anananu/Square-wave-Generator/Simulations/Temperatura2.jpg

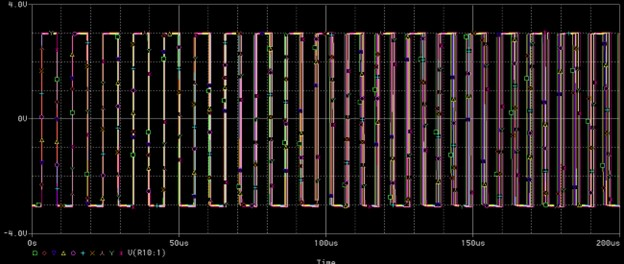
Simulations/Temperatura2.jpg
