anananu/Square-wave-Generator/Simulations/Temperatura1.jpg

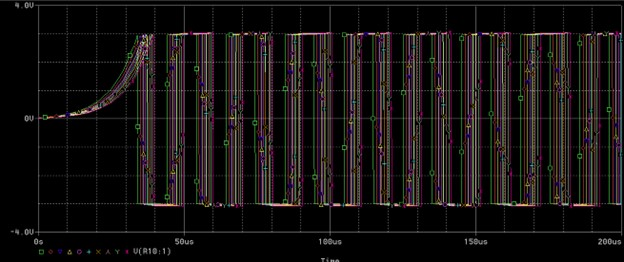
Simulations/Temperatura1.jpg
