anananu/Square-wave-Generator/P1_2023_434D_Nanu_AnaMaria_final.pptx

## Proiect 1 – Dispozitive și circuite electronice (DCE)

Tema: Generator de semnal dreptunghiular

Student: Nanu Ana-Maria
Grupa: 434D

## Date de proiectare

Cerințe electrice:
• Frecvența de oscilație, f_0 , reglabilă în intervalul 48-96 KHz;
• Factor de umplere: 0.5;
• Sarcina la ieșire, R_L : 24kΩ;
• Valoarea (vârf la vârf) a oscilației la ieșire, V_0 , reglabilă în intervalul 0-6V;
• Semnalul la ieșire nu are componentă continuă;
• Domeniul temperaturilor de funcționare: -20° - 120°C
• Semnalizarea prezenței tensiunilor de intrare/ieșire cu o diodă de tip LED
Cerințe tehnologice:
- Dimensiunile PCB: 40mm x 40mm;
- Material FR4, dublu strat;
- Originea (punctul de coordonate (0,0)) va fi plasat în colţul din stânga-jos al plăcii de cablaj imprimat)
- Dimensiuni trasee:
      - Curent de 1A - 30 mil;
      - Curent de sute de mA - 20 mil;
      - Semnal - 16 mil;

## Schema bloc

Oscilatorul de relaxare este constituit dintr-un comparator inversor cu histerezis și o rețea RC pe intrarea inversoare.
Intrarea neinversoare este conectată la un divizorul de tensiune, prin intermediul căruia de aplică o parte din semnalul de la ieșire și prin care se fixează tensiunile de prag de histerezis.
Gruparea RC, la care se adaugă un potențiometru, setează frecvența de oscilație.
Amplificatorul operațional este alcătuit din trei etaje de amplificare.

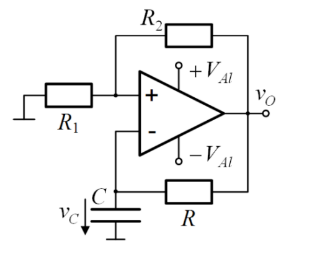
[picture p3: figure]
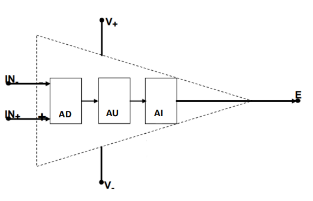
[picture p4: figure]

## Schema electrică

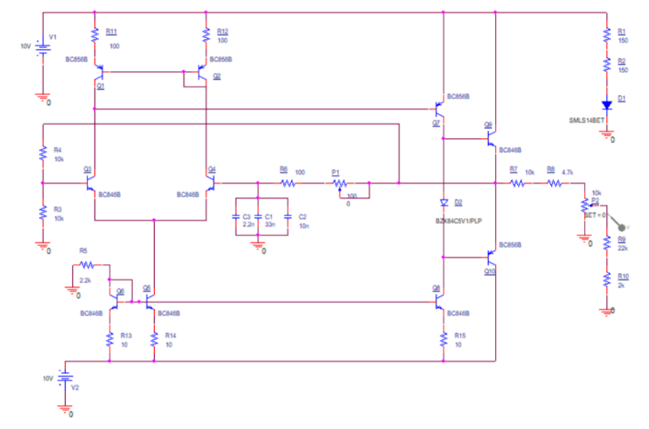
[picture p5: figure]

Etaj diferențial

Etaj de
amplificare
în curent

LED

Divizor rezistiv

Gruparea RC

Rezistența
de
sarcină

Etaj de amplificare în tensiune

## Simulări

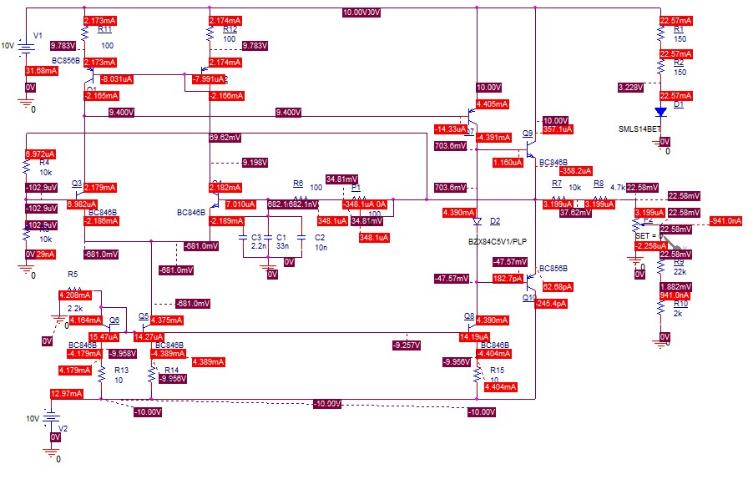
[picture p6: figure]

## Simulări

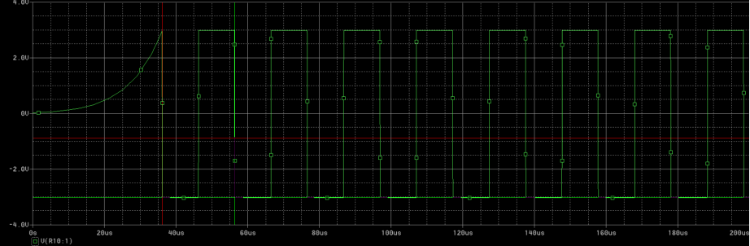
[picture p7: figure]
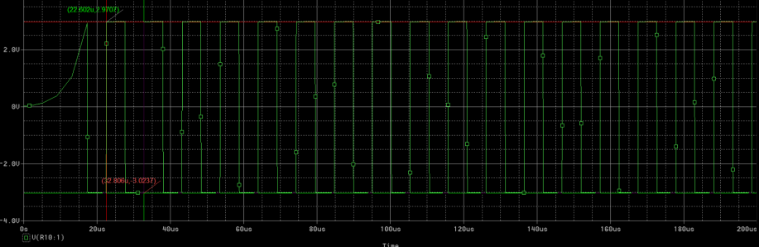
[picture p8: figure]

## Layout

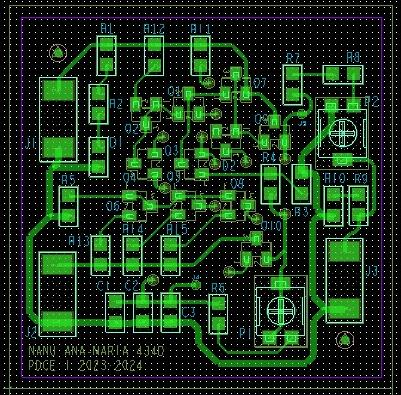
[picture p9: figure]

Vedere Top
Poziționarea componentelor s-a realizat pe baza următoarelor condiții:
- Componentele pasive au fost așezate spre exteriorul plăcii, iar cele active, în mijloc.
- Tranzistoarele au fost plasate cât mai aproapiate pentru a concentra distribuția căldurii.

## Layout

Vedere Bottom
- Dimensiunile traseelor s-au setat în concordață cu cerințele de proiectare.

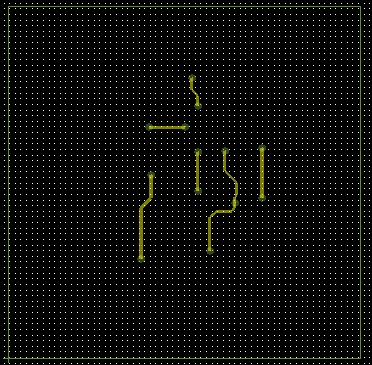
[picture p10: figure]

## Fotografii din etapa de echipare a modulului electronic

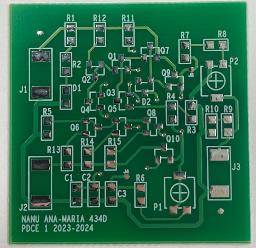
[picture p11: figure]
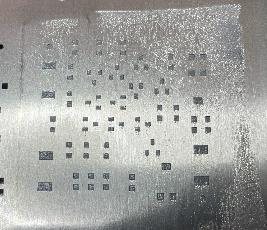
[picture p12: figure]
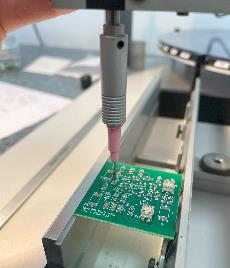
[picture p13: figure]
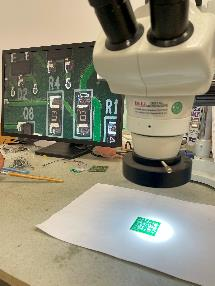
[picture p14: figure]
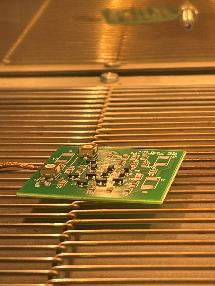
[picture p15: figure]
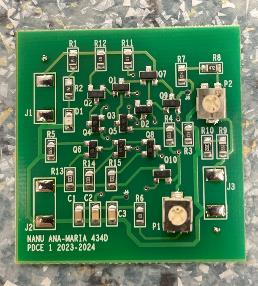
[picture p16: figure]

## Rezultate experimentale

Realizarea montajului pentru testarea modulului

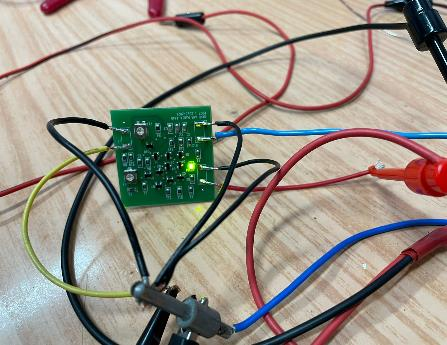
[picture p17: figure]

1

1

4

3

1

2

1. Firele negre – Ground
2. Firul roșu – Alimentarea cu +Vcc

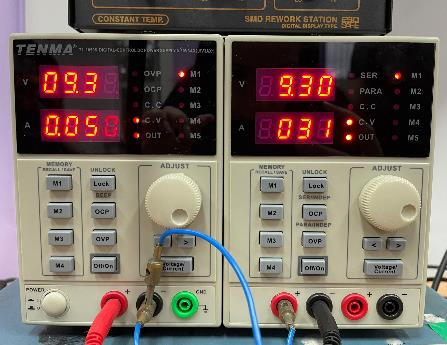
[picture p18: figure]

3. Firul albastru – Alimentarea cu –Vcc
4. Firul galben - Vout

## Rezultate experimentale

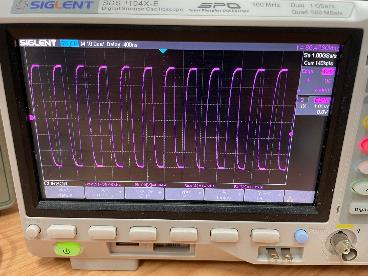
[picture p19: figure]

f = 86.473 kHz, V_0 = 6.04 V_(PP)

Formele de undă obținute

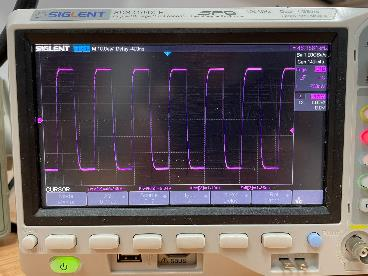
[picture p20: figure]
f = 48kHz, A = 6Vpp

f = 48.256 kHz, V_0 = 6.04 V_(PP)

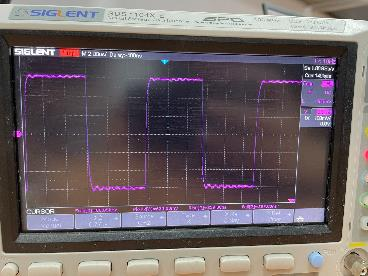
[picture p21: figure]

f = 86.85 kHz, V_0 = 0.62 V_(PP)

## Rezultate experimentale

- Tabel comparativ

Cerințe impuse | Rezultate simulări | Rezultate măsurători
f_(min) =48kHz | f_(min) =49.27kHz | f_(min) =48.256kHz
f_(max) =96kHz | f_(max) =96kHz | f_(max) =86.85kHz
V_(0_(min)) =0V_(PP) | V_(0_(min)) =743nV_(PP) | V_(0_(min)) =0.62V_(PP)
V_(0_(max)) =6V_(PP) | V_(0_(max)) =5.99V_(PP) | V_(0_(max)) =6.04V_(PP)
η=0.5 | η=0.51 | η=0.49
V_(offset) =0V_(PP) | V_(offset) =0.023V_(PP) | V_(offset) =0V_(PP)

## Concluzii – rezultatele obținute

Avantaje
- Frecvența minimă rezultată din măsurători a fost mai aproape de cea din cerințele de proiectare, decât cea simulată.
- Factorul de umplere și offset-ul au avut deviații neglijabile în comparație cu valorile dorite.
- Valorile amplitudinii au rămas apropiate de cele din cerință. În ceea ce privește tensiunea minimă, aceasta a ajuns la valori foarte apropiate de 0, însă am fotografiat o valoare minimă pentru care se vedea forma de undă dorită.

Dezavantaje
- Frecvența maximă nu a ajuns la pragul dorit de 96kHz, fapt datorat potențiometrului P_2 , cu valoarea nominală de 10kΩ, care, în urmă măsurătorilor, a avut valoarea maximă de 8.56kΩ, fapt ce a condus la o eroare considerabilă, de 9.56%. O îmbunătățire ce ar putea fi adusă în acest caz, ar fi schimbarea potențiometrului și luarea în considerare a toleranței acestuia.
- Semnalul obținut nu a avut întocmai forma de undă perfect dreptunghiulară, fapt ce se datorează grupării de condensatoare C_1 , C_2 , C_3 . Corectarea ar fi putut fi făcută prin alegerea mai potrivită a valorilor acestora.

## Concluzii

- Plan de depanare –
organigrama
- Cunoștințe dobândite: Calculul și proiectarea circuitelor după anumite cerințe impuse, teoria circuitelor electronice fundamentale, depanarea circuitelor, utilizarea software-ului de proiectare OrCAD
- Consider că acest proiect a reprezentat o bună punere în practică a cunoștințelor dobândite la materiile anterioare și că am fixat mult mai bine o parte dintre noțiuni
- Modalitatea de desfășurare cred că a fost una bine structurată, însă o îmbunătățire semnificativă ar fi planificarea din timp a evaluărilor astfel încât să nu se întindă pe mai mult de 2 săptămâni și a deadline-urilor pentru încărcarea proiectelor pentru ca toată lumea să poată posta la timp

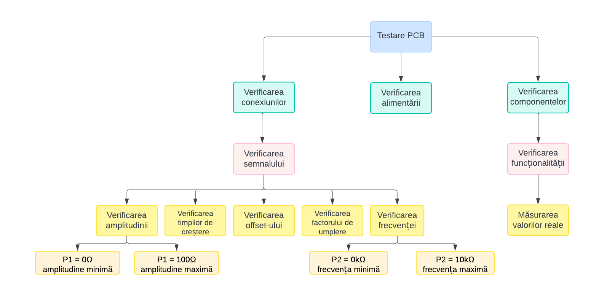
[picture p22: figure]

## Discipline studiate utile în realizarea proiectului

- Disciplinele din care au fost utilizate cunoștințe/informații pentru realizarea proiectului
  1. Dispozitive Electronice
  2. Circuite Integrate Analogice
  3. Circuite Electronice Fundamentale
  4. Tehnici CAD în realizarea modulelor electronice
  5. Tehnologii de interconectare în electronică
  6. Componente și circuite pasive
  7. Bazele Electrotehnicii
- Ce discipline, aflate în semestrele din amonte, ar fi trebuit să fie mai bine însușite pentru ușurarea realizării activităților conexe proiectului?
  1. Dispozitive Electronice
  2. Circuite Electronice Fundamentale
  3. Circuite Integrate Analogice
