anananu/Square-wave-Generator/Documentație.pdf

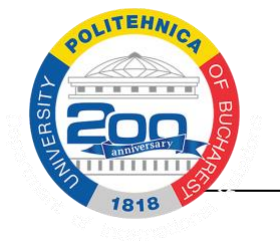
[picture p23: figure]
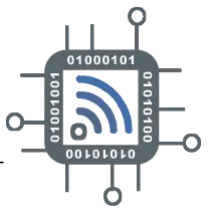
[picture p24: figure]

## UNIVERSITATEA NAȚIONALĂ DE ȘTIINȚĂ ȘI TEHNOLOGIE POLITEHNICA BUCUREȘTI

### Facultatea de Electronică, Telecomunicații și Tehnologia Informației

## Proiect 1 – Dispozitive și circuite electronice

## Generator de semnal dreptunghiular

### Student: Nanu Ana-Maria Grupa: 434D

### Profesori coordonatori: Conf. Dr. Ing. Drăghici Florin Ș.l. Dr. Ing. Pantazică Mihaela

# Cuprins

# 1.Date inițiale de proiectare

## 1.1. Tema proiectului

### Să se proiecteze și realizeze un generator de semnal dreptunghiular cu următoarele caracteristici:

- Frecvența de oscilație, f0, reglabilă în intervalul 48-96 KHz;
- Factor de umplere: 0.5;

### - Sarcina la ieșire, RL

: 24kΩ;
- Valoarea (vârf la vârf) a oscilației la ieșire, Vo, reglabilă în intervalul 0-6V;
- Semnalul la ieșire nu are componentă continuă;

### - Domeniul temperaturilor de funcționare: -20° - 120°C (verificabil prin

testare în temperatură);
- Semnalizarea prezenței tensiunilor de intrare/ieșire cu o diodă de tip LED.

## 1.2. Schema bloc a montajului electric

Vom folosi un circuit basculant astabil, mai exact un oscilator de relaxare.

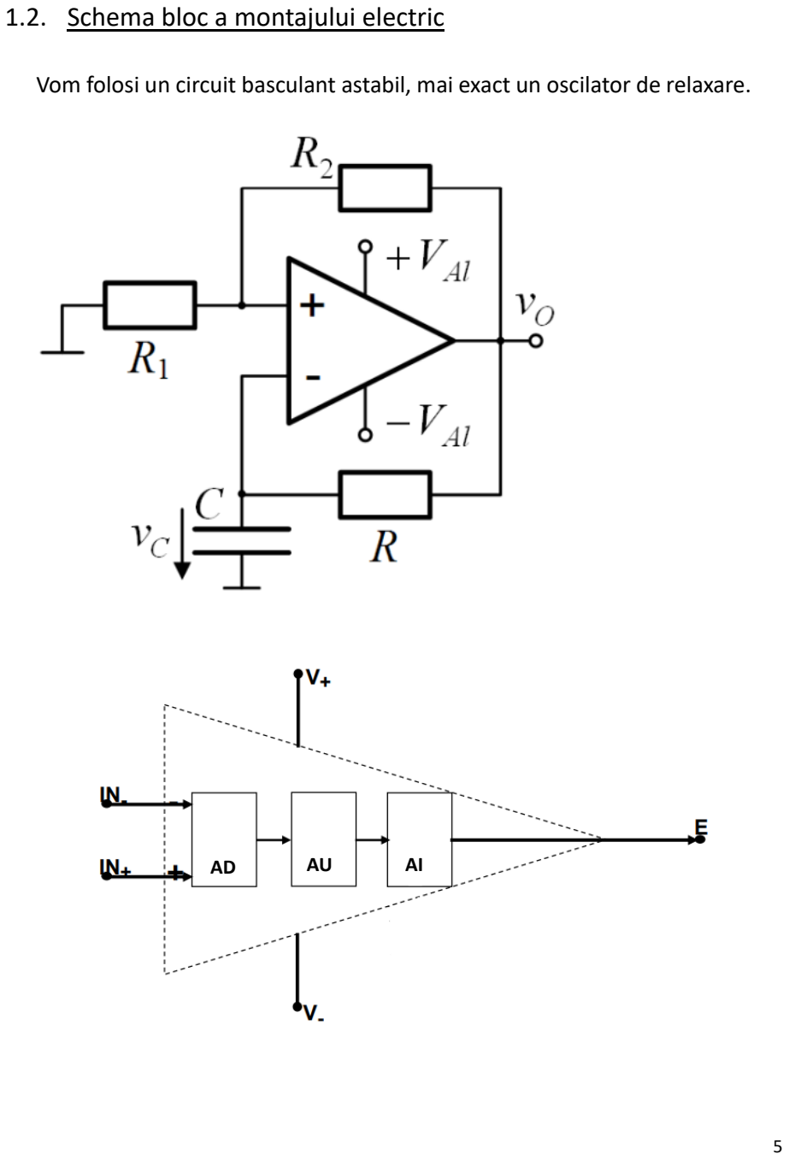
[picture p25: page 5]

AD | AU | AI

## 1.3. Schema electrică a montajului electric

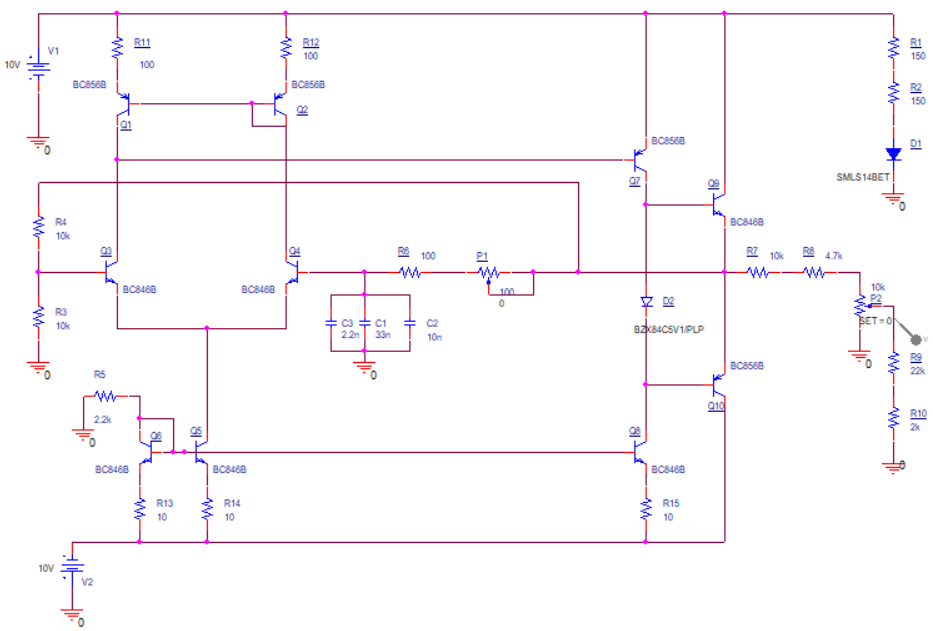
[picture p26: figure]

# 2.Conținut tehnic/științific al proiectului

## 2.1. Descrierea funcțională a circuitului

### Am construit un oscilator de relaxare dintr-un comparator inversor cu histerezis și

o rețea RC pe intrarea inversoare.

### Intrarea neinversoare este conectată la divizorul de tensiune format din R3 și R4, prin intermediul căruia de aplică o parte din semnalul de la ieșire și prin care se fixează

tensiunile de prag de histerezis.

Gruparea formată din C1, C2, R7 și P1 setează frecvența de oscilație.

### Amplificatorul operațional folosit este unul standard, format din 3 etaje de amplificare:

- etaj de amplificare diferențială;
- etaj de amplificare în tensiune;
- etaj de amplificare în curent.

Am folosit două surse de alimentare de ±10V.

### 2.1.1. Etajul diferențial

### Acest etaj este unul de tip transconductanță, transformând un semnal de tip tensiune, într-unul de tip curent. Acesta are o impedanță de intrare mare, ce permite adaptarea impedanței între sursa de semnal și următorul etaj din

amplificatorul operațional.

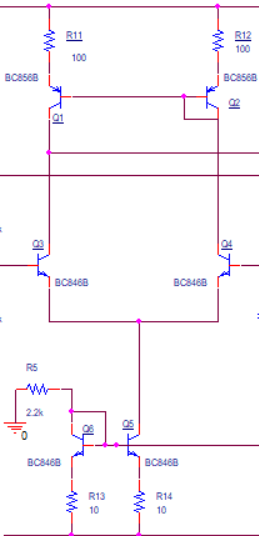
[picture p27: figure]

### Etajul principal este format din tranzistoarele Q3 și Q4, NPN, de tip BC846B, în baza cărora se vor

afla intrările amplificatorului operațional.

### Pentru a mări câștigul, stabilitatea și pentru a reduce zgomotul, adăugăm două etaje auxiliare:

oglinda și sursa de curent.

### Tranzistoarele PNP, BC856B, Q1 și Q2 sunt folosite pentru a avea același curent în colectorul celor două tranzistoare ce formează principala parte

din etajul diferențial.

### Pentru polarizarea tranzistoarelor am folosit sursa de curent formată din Q5, Q6 și R5. Astfel am asigurat un IREF = 4.27mA ce permite crearea

unui semnal dreptunghiular perfect drept.

### 2.1.2. Etajul de amplificare în tensiune

### Am folosit un etaj de tip transimpedanță, ce are rolul de a obține

o tensiune mare, transformând curentul de la intrare.

### Având o amplificare mare în buclă deschisă, am folosit o buclă de reacție negativă pentru a adapta valoarea tensiunii la cea

specificată în datele inițiale de proiectare.

### Amplificarea este realizată de tranzistorul PNP, BC856B, Q7, aflat în conexiune emitor-comun, ceea ce face ca acesta să aibă o amplificare mare. Rolul său este de a regla tensiunea la valoarea

dorită. Are ca sarcină o sursă de curent formată din Q8.

Sursa de curent comandă curentul din etajul final.

### 2.1.3. Etajul de amplificare în curent

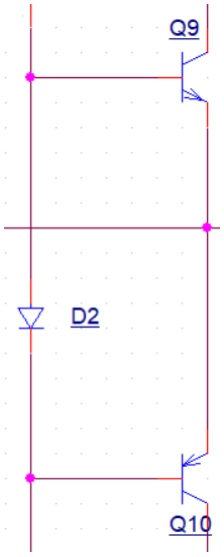
[picture p28: figure]

### Acest etaj ar trebui să aibă o amplificarea unitară a tensiunii reglate în etajul anterior, motiv pentru care s-a folosit o conexiune de tip colector comun. Tranzistorul Q9 este de tip BC846B, iar Q10 de tip BC856B. Ele vor disipa o putere semnificativă, datorită curentului care va trece și prin

sarcină.

### Cele două tranzistoare formează o configurație de tip push-

pull, specifică amplificatoarelor de clasă B. Q9 | este
responsabil pentru alternanța pozitivă, iar Q10 | pentru
alternanța negativă.

### Dioda Zener D1 stabilește tensiunile bază-emitor de deschidere pentru cele două tranzistoare și reduce

distorsiunile.

### 2.1.4. LED

Conform cerințelor am semnalizat tensiunile de intrare în circuit printr-un led de tip SMLS14BET, în serie cu rezistența R1 și R2. Luând în considerare puterea maximă admisă (117mW) și valoarea tensiunii de funcționare uzuală pentru acesta (3.32V), precum și curentul necesar pentru aprindere [0.1 – 1 A], am ales valoarea de 150Ω pentru

rezistențe.

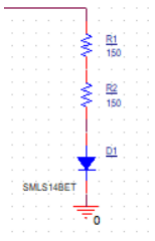
[picture p29: figure]

## 2.2. Calcul de dimensionare

### 2.2.1. Frecvența de oscilație

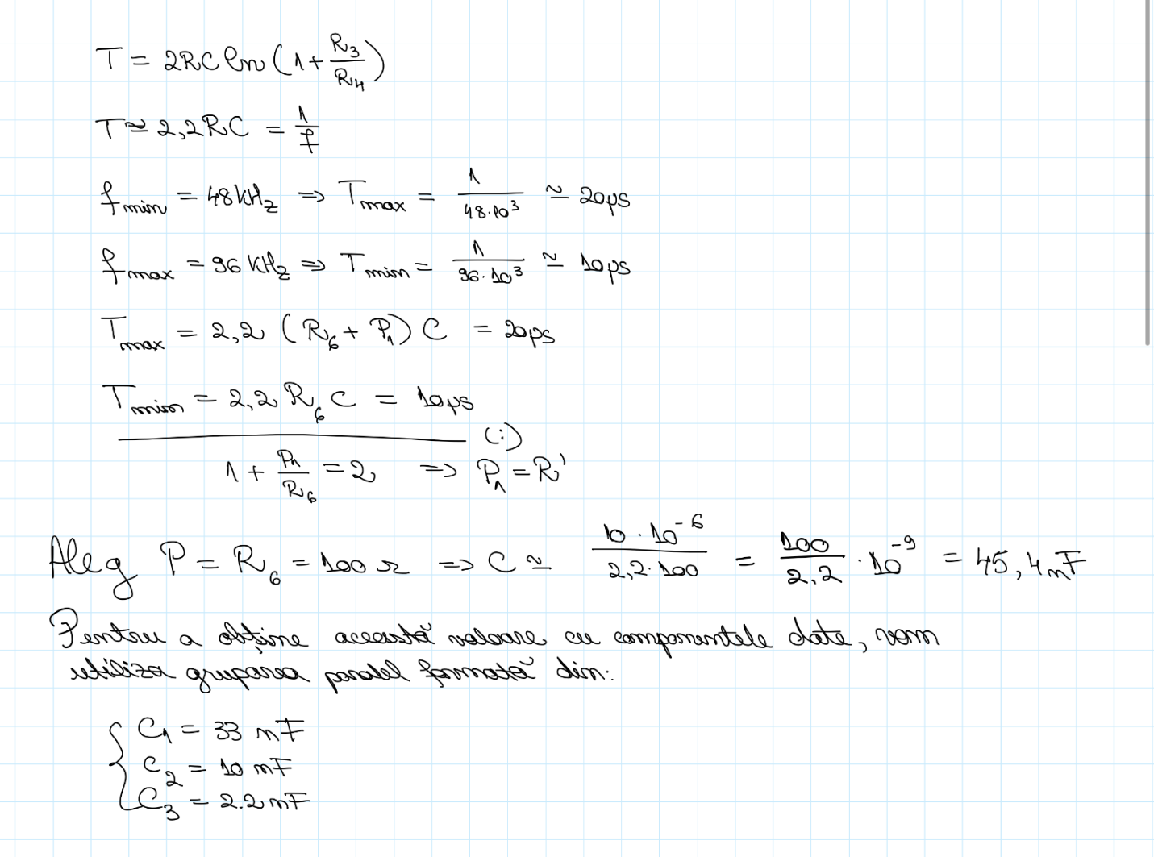
[picture p30: figure]

### 2.2.2. Tensiunea vârf la vârf

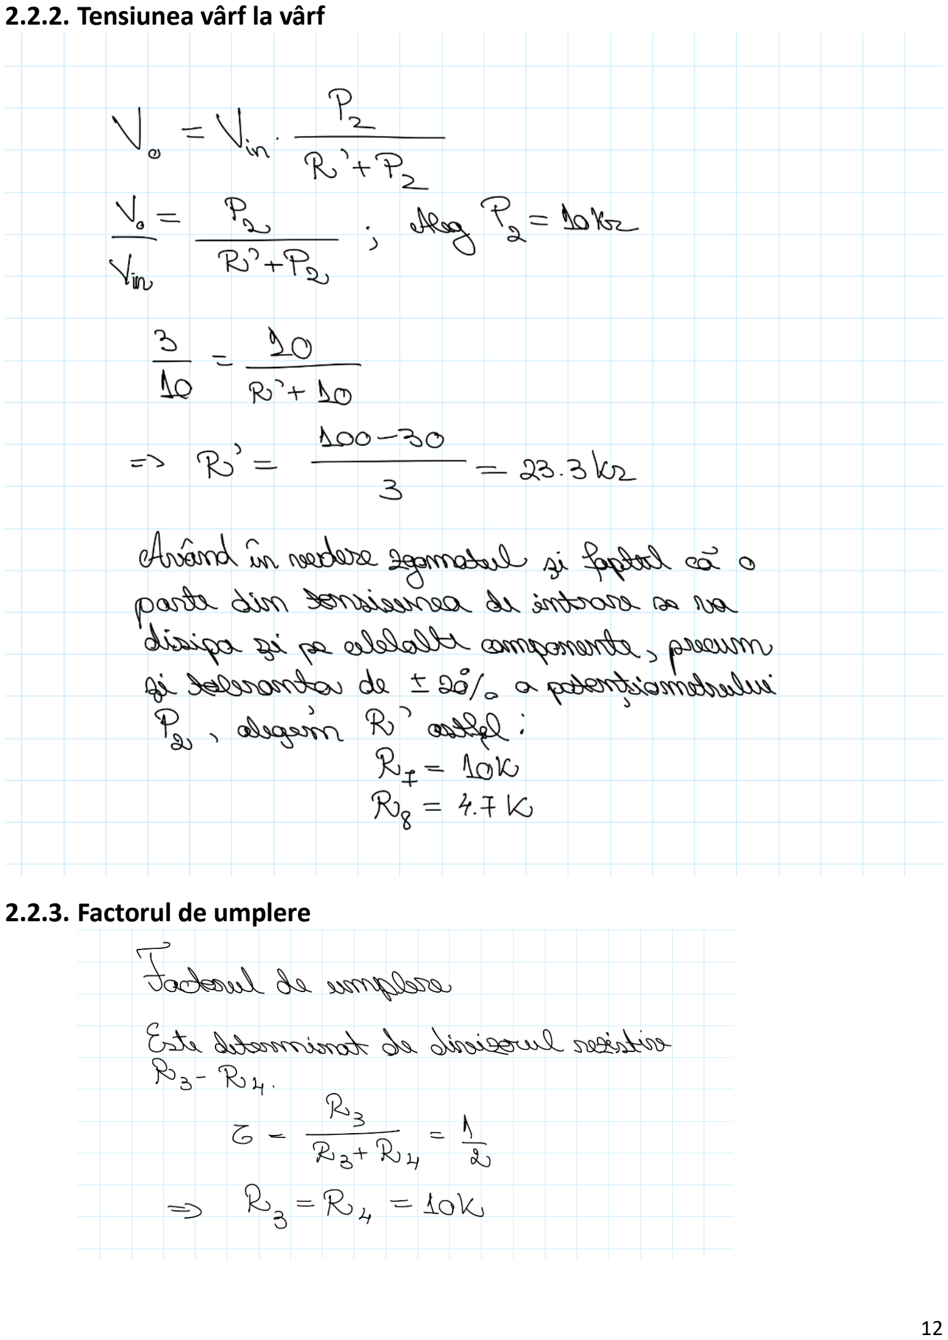
[picture p31: page 12]

### 2.2.3. Factorul de umplere

## 2.3. Punctul static de funcționare

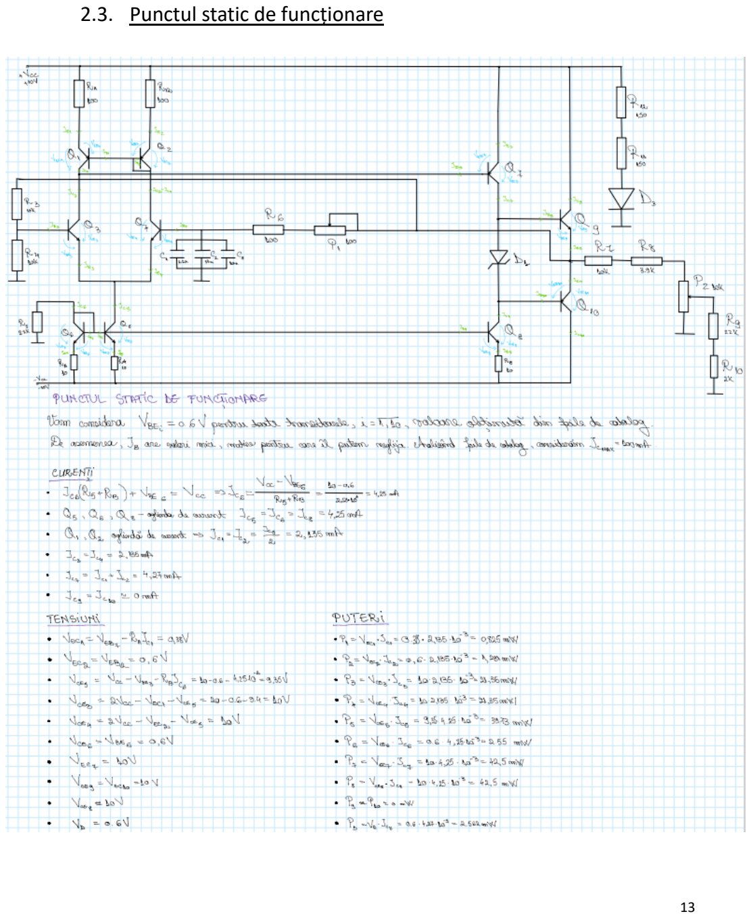
[picture p32: page 13]

# 3. Simularea montajului electric

## 3.1. Curenți

### Verificând foile de catalog ale componentelor, acestea merg în regulă la curenții

obținuți.

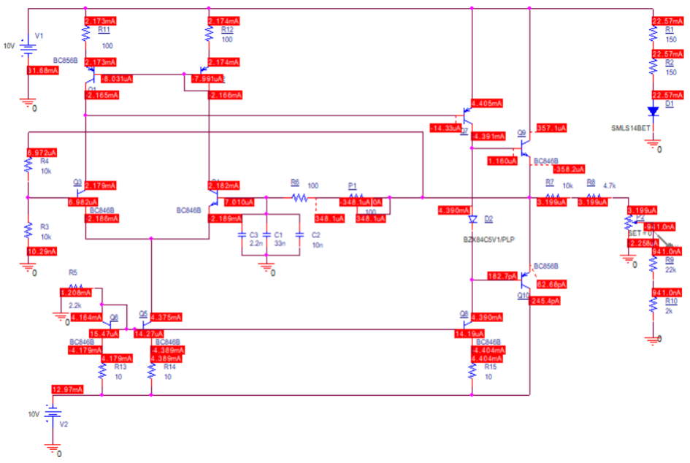
[picture p33: figure]

## 3.2. Tensiuni

### Verificând foile de catalog ale componentelor, acestea merg în regulă pentru

tensiunile obținute.

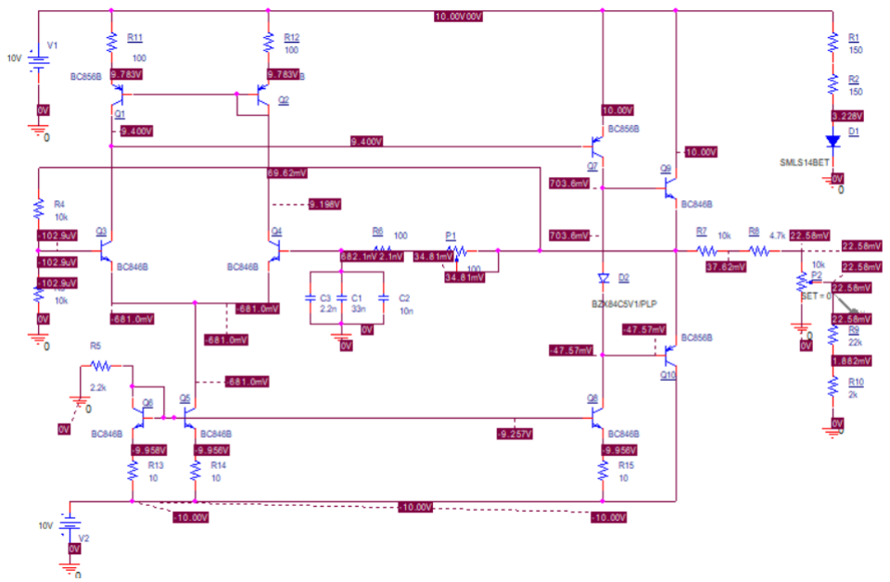
[picture p34: figure]

## 3.3. Puteri

### De asemenea, și puterile se încadrează în parametrii normali de funcționare a

componentelor.

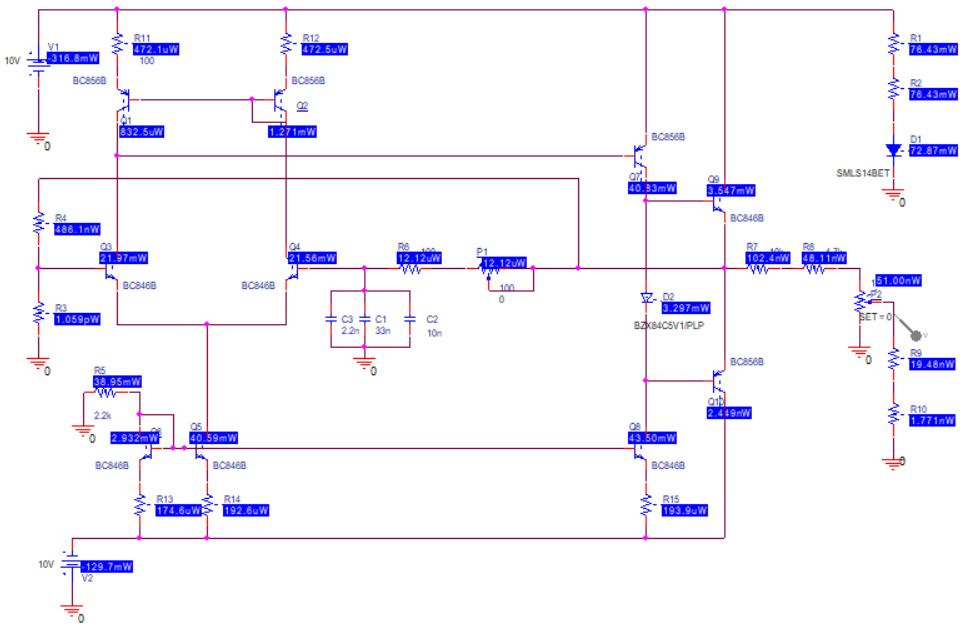
[picture p35: figure]

3.4. P1 = 0, P2 = 10kΩ.

### Pentru aceste valori se obțin:

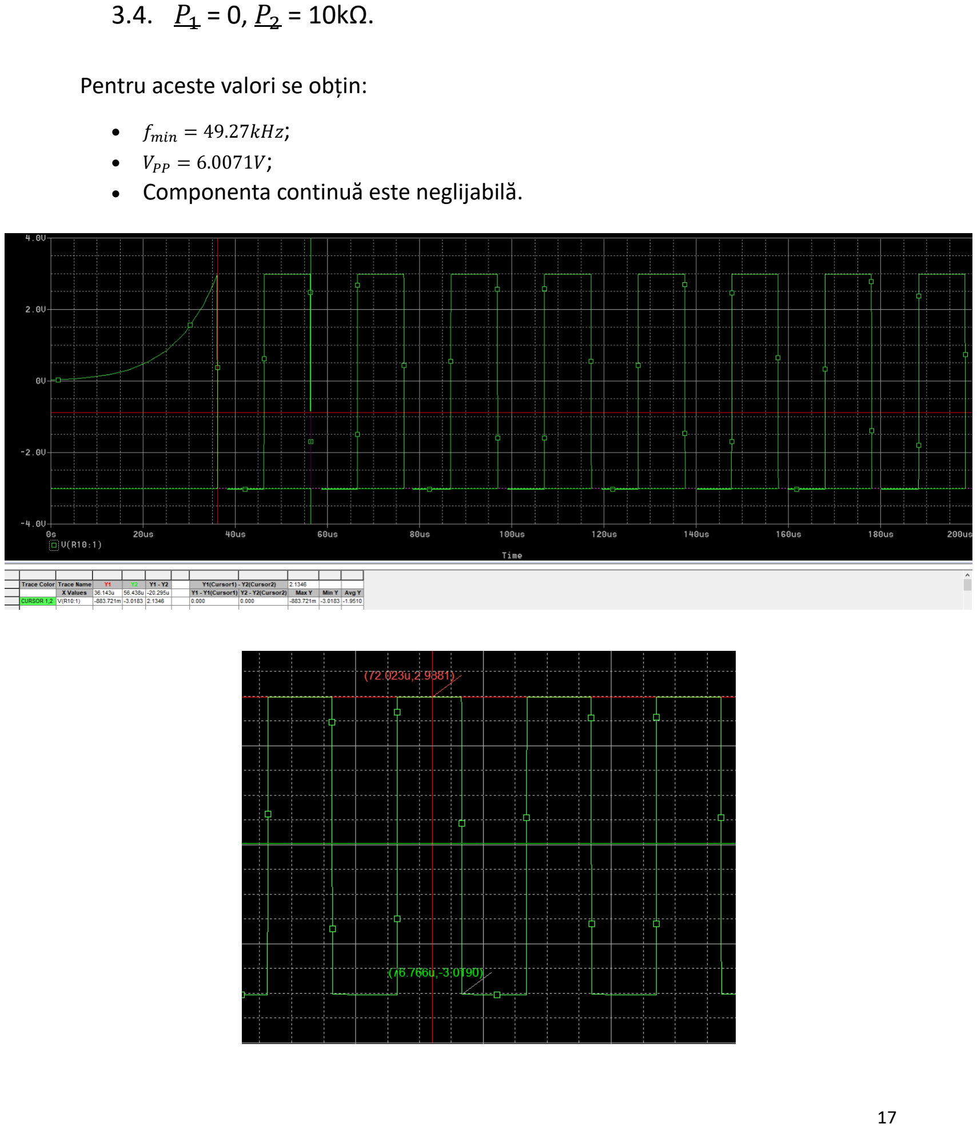
[picture p36: page 17]

- fmin = 49.27kHz;
- VPP = 6.0071V;
- Componenta continuă este neglijabilă.

3.5. P1 = 100Ω, P2 = 10kΩ.

### Pentru aceste valori se obțin:

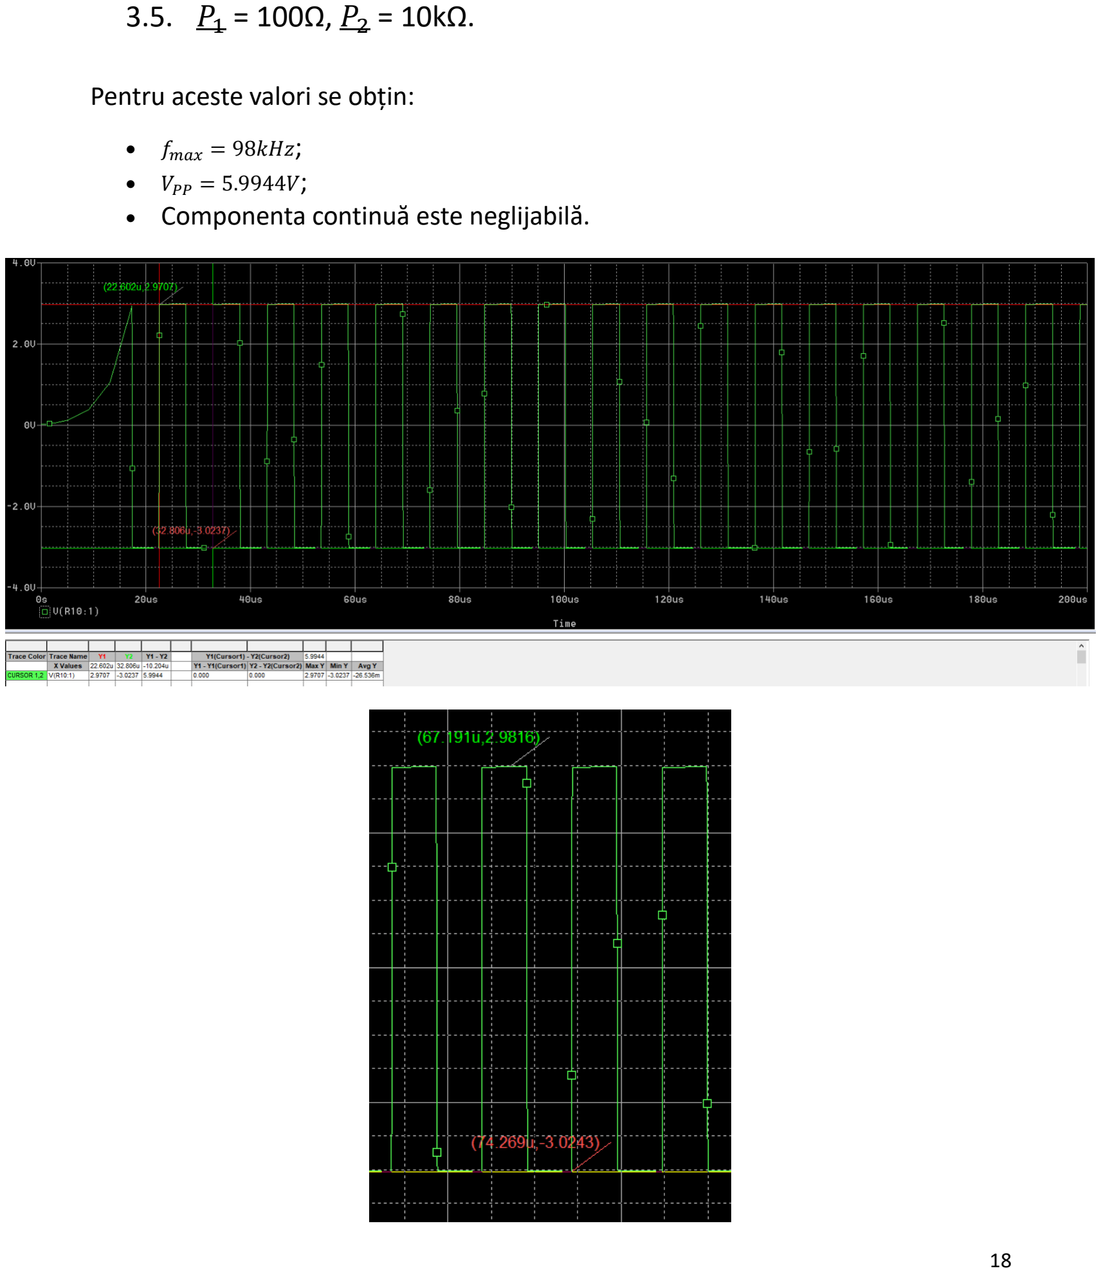
[picture p37: page 18]

- fmax = 98kHz;
- VPP = 5.9944V;
- Componenta continuă este neglijabilă.

## 3.6. P1 = 100Ω & P1 = 0, P2 = 0

### Pentru aceste valori se obțin:

- fmax = 98kHz & fmin = 49.27kHz;
- VPP = 743nV;

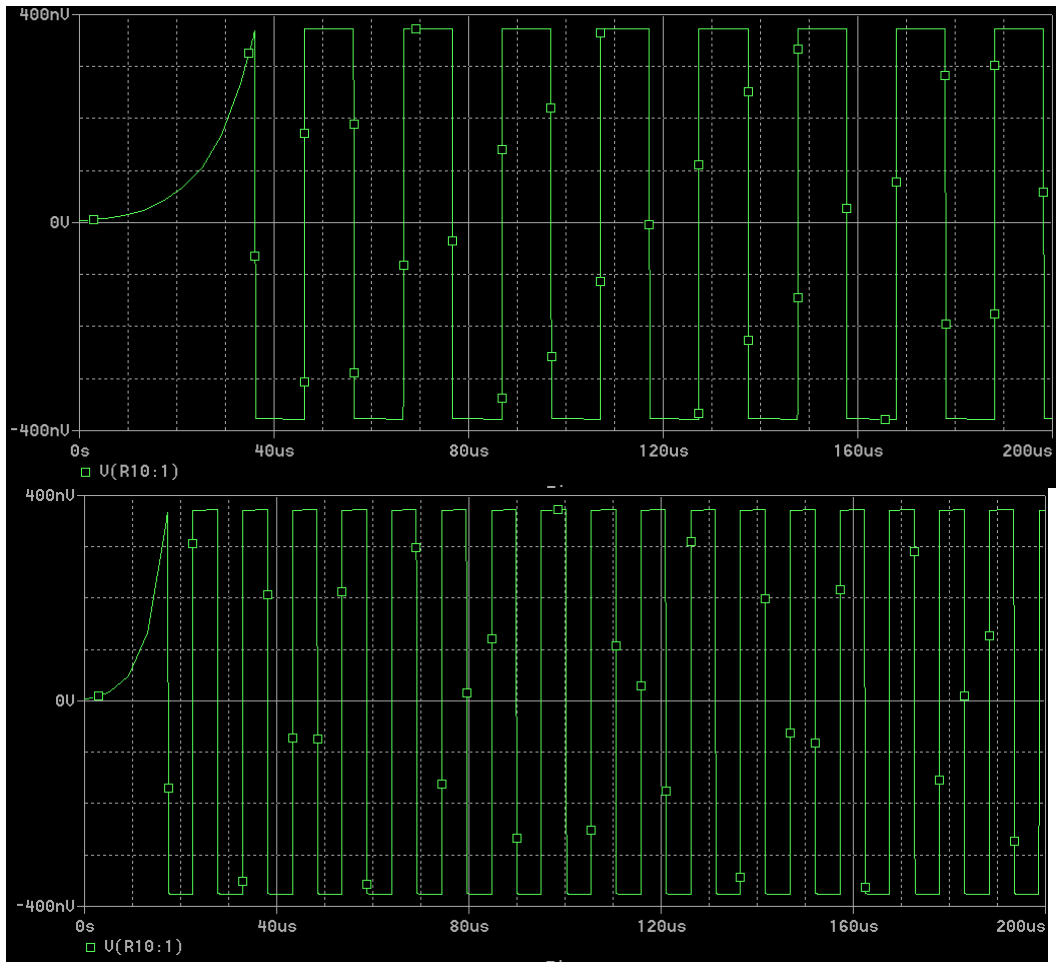
[picture p38: figure]

## 3.7. Temperatură

Am simulat funcționarea circuitului la -20°, 0°, 20°, 27°, 40°, 60°, 80°, 100°, 120°C, toate componentele funcționând normal în tot intervalul de temperatură.

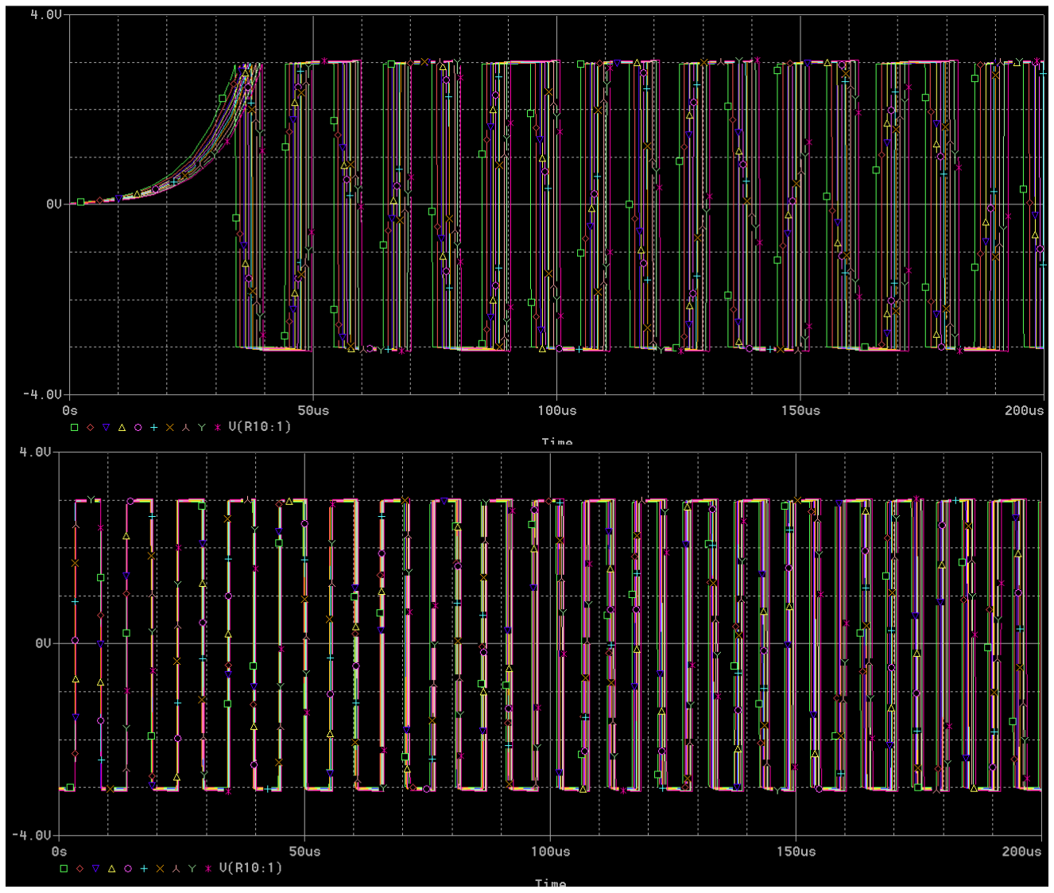
[picture p39: figure]

# 4.BOM

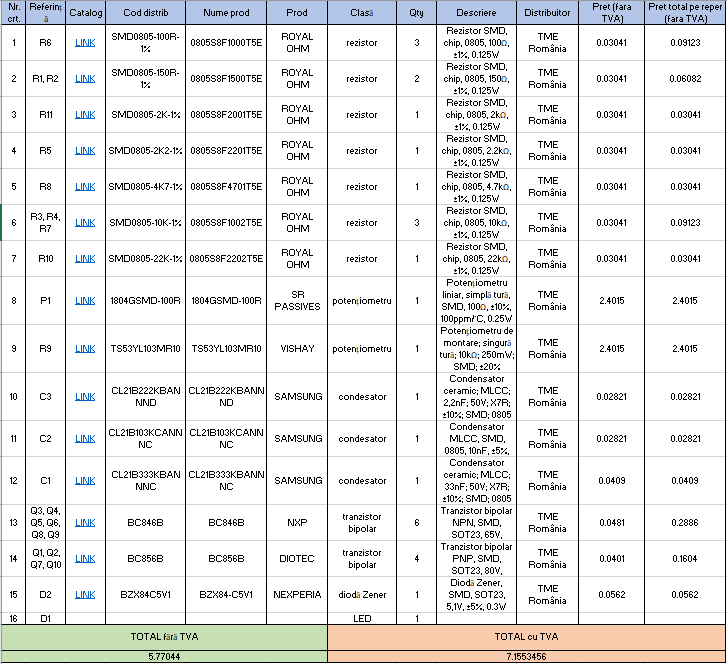
[picture p40: figure]

# 5. Layout

## 5.1. PCB design

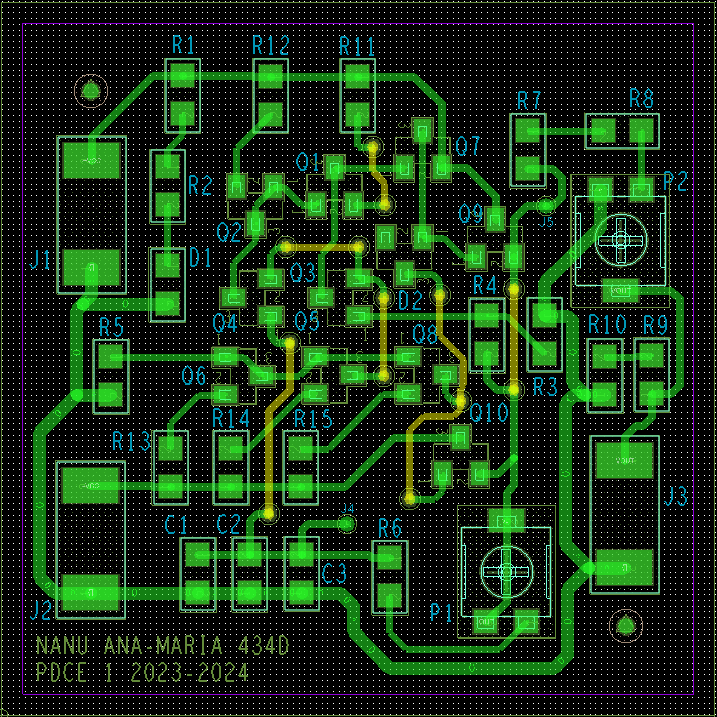
[picture p41: figure]

## 5.2. BOARD OUTLINE

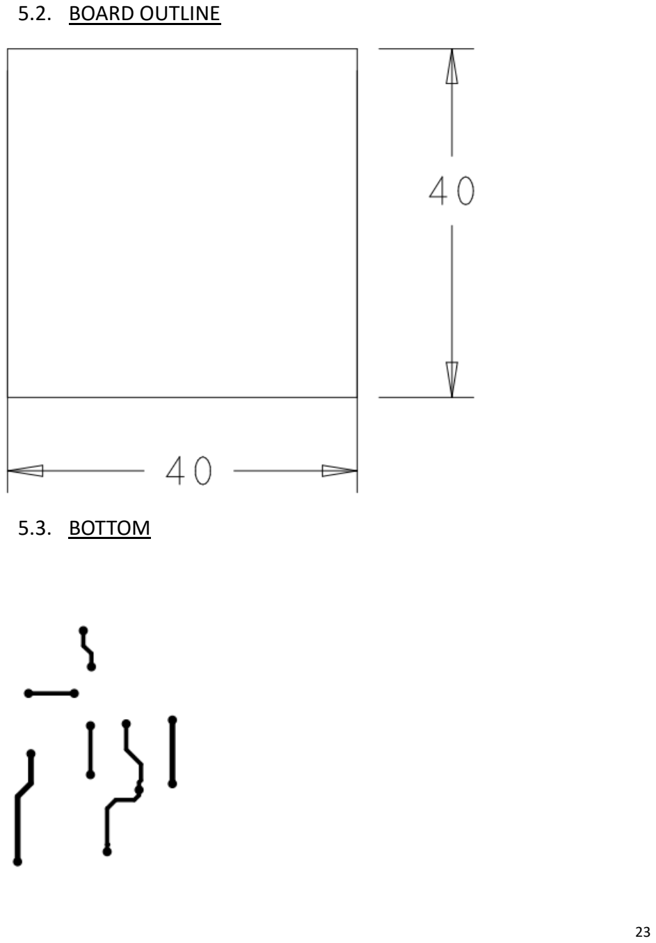
[picture p42: page 23]

## 5.3. BOTTOM

## 5.4. FABRICATION

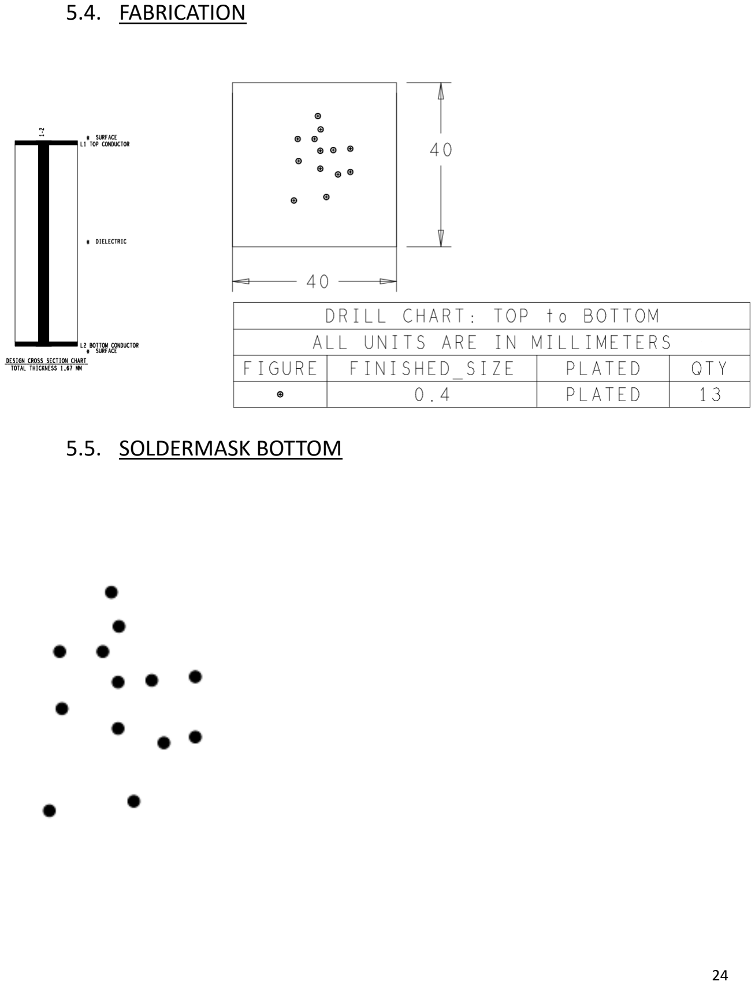
[picture p43: page 24]

## 5.5. SOLDERMASK BOTTOM

## 5.6. SOLDERMASK TOP

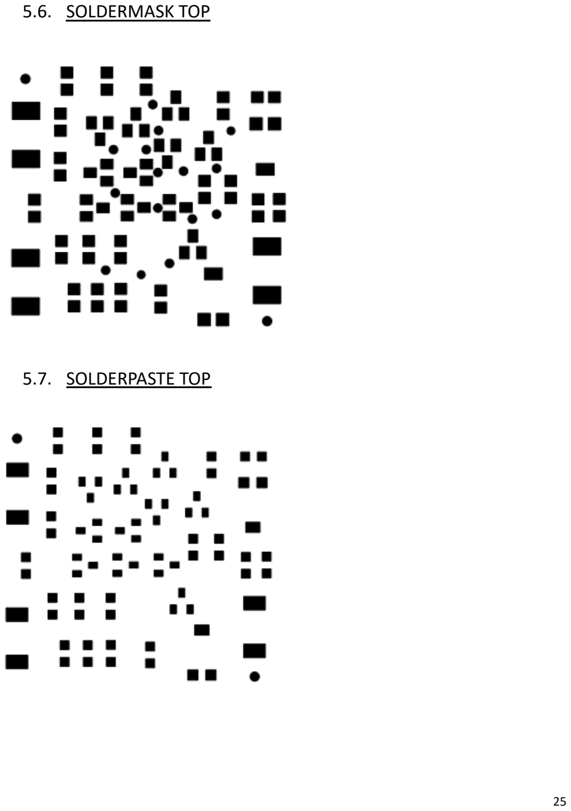
[picture p44: page 25]

## 5.7. SOLDERPASTE TOP

## 5.8. SILKSCREEN TOP

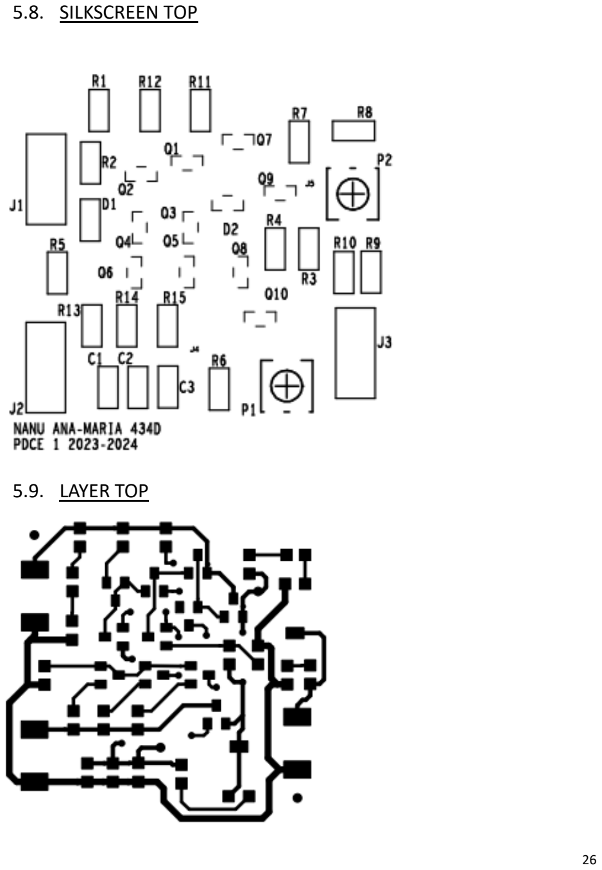
[picture p45: page 26]

## 5.9. LAYER TOP

## 5.10. FINAL

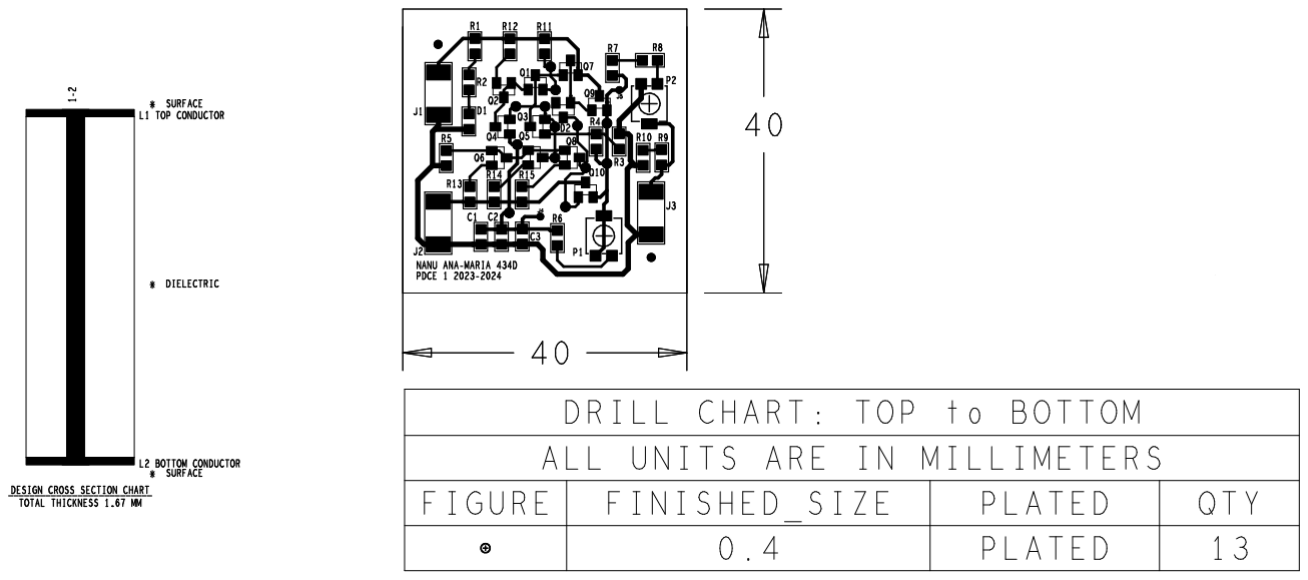
[picture p46: figure]

# 6.Bibliografie și webografie

- CODREANU N., PANTAZICĂ M., IONESCU C., MARCU A., Tehnici CAD de realizarea modulelor electronice, București, Editura CAVALLIOTI, 2017 - BREZEANU GH., DRĂGHICI F., DILIMOȚ GH., MITU F., Circuite electronice fundamentale, București, Editura ROSETTI EDUCATIONAL, 2009 - Curs DE și CEF - Curs CIA - https://eprofu.ro/docs/electronica/analogica/circuite/filtre-oscilatoare.pdf - http://www.bel.utcluj.ro/dce/didactic/cef/20_generatoare_nesinusoidale.p df (http://www.bel.utcluj.ro/dce/didactic/cef/20_generatoare_nesinusoidale.pdf)
