anananu/Square-wave-Generator/Schematics/Schema.jpg

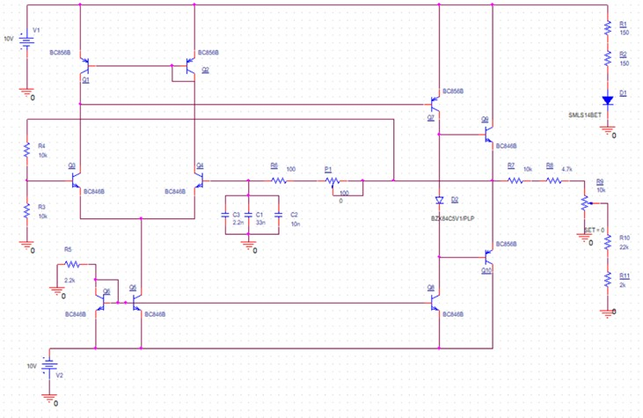
Schematics/Schema.jpg
