anananu/Square-wave-Generator/Simulations/Amplitudinea varf la varf maxima.jpg

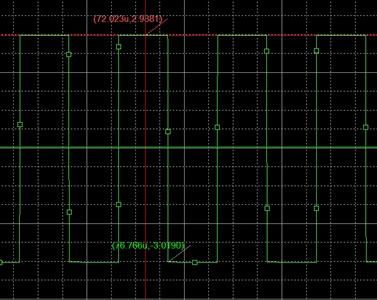
Simulations/Amplitudinea varf la varf maxima.jpg
