anananu/Square-wave-Generator/Simulations/Amplitudinea varf la varf minima.jpg

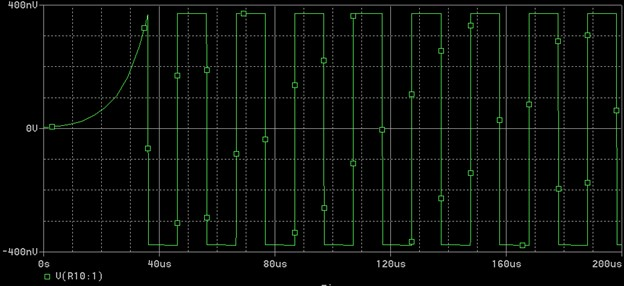
Simulations/Amplitudinea varf la varf minima.jpg
