anananu/Square-wave-Generator/Simulations/Frecventa maxima.jpg

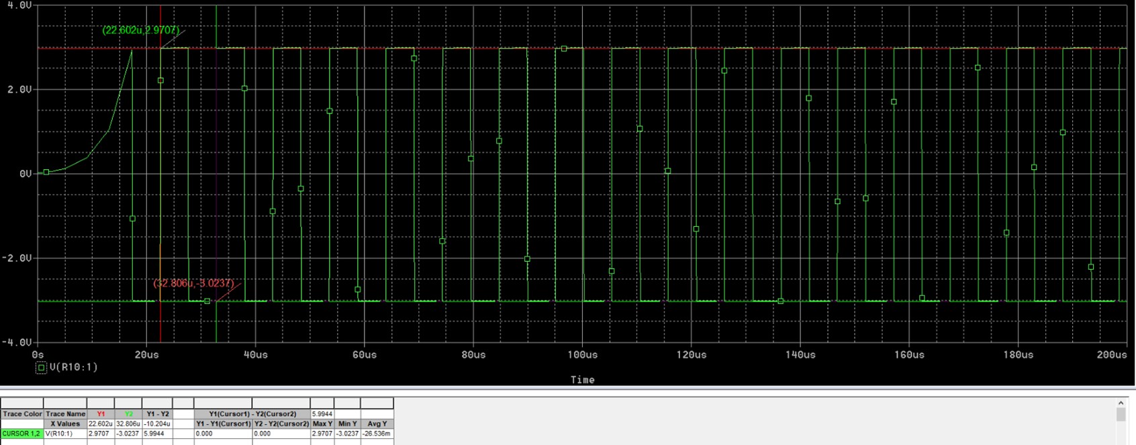
Simulations/Frecventa maxima.jpg
