anananu/Square-wave-Generator/Simulations/Frecventa minima.jpg

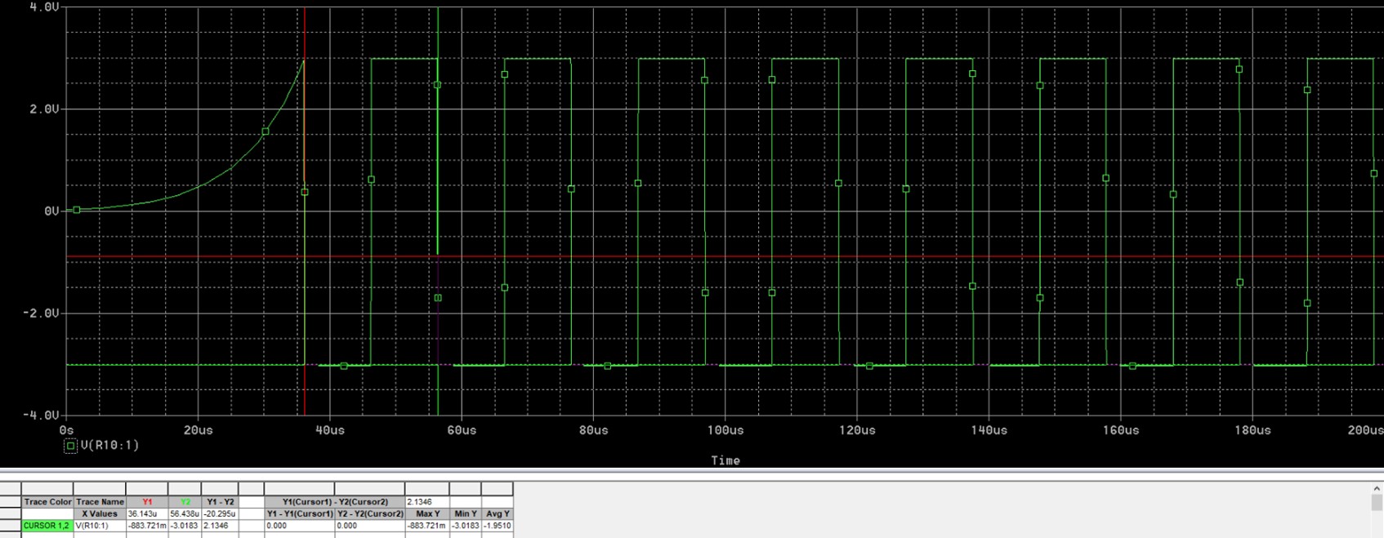
Simulations/Frecventa minima.jpg
