anananu/Square-wave-Generator/Bill Of Materials/Anexa_a1_grupa_434D.xlsx

Sheet: Sheet1
Anexa a1 - Grupa 434D -Tema 16 - Generator de semnal dreptunghiular
Nr. Crt. | Nume | Catalog | Cod distrib | Nume prod | Prod | Clasă | Qty fix | Qty final | Qty min | Alveole | Descriere | Distribuitor | Pret (fara TVA) referinta/buc. TME România | Pret total pe reper (fara TVA)
1 | 0 ohm | (LINK) (http://www.tme.eu/ro/details/smd1206-0r/rezistente-smd-1206/royal-ohm/1206s4j0000t5e/) | 1206S4J0000T5E | 1206S4J0000T5E | SR PASSIVES | rezistor | 100 |  |  |  | Rezistor: thick film; SMD; 1206; 0Ω; 0,25W; ±5%; -55÷125°C | TME România | 0.03041 | 3.041
2 | 0.47 | (LINK) (http://www.tme.eu/ro/details/smd0805-0r47/rezistente-smd-0805/royal-ohm/0805s8j047kt5e/) | SMD0805-0R47 | 0805S8J047KT5E | ROYAL OHM | rezistor | 20 |  |  |  | Rezistor SMD, chip, 0805, 0.47Ω, ±5%, 0.125W | TME România | 0.04719 | 0.9438
3 | 1 | (LINK) (http://www.tme.eu/ro/details/smd0805-1r-1%25/rezistente-smd-0805/royal-ohm/0805s8f100kt5e/) | SMD0805-1R-1% | 0805S8F100KT5E | ROYAL OHM | rezistor | 20 |  |  |  | Rezistor SMD, chip, 0805, 1Ω, ±1%, 0.125W | TME România | 0.0367 | 0.734
4 | 4.7 | (LINK) (http://www.tme.eu/ro/details/smd0805-4r7-1%25/rezistente-smd-0805/royal-ohm/0805waf-4r7-t5e/) | SMD0805-4R7-1% | 0805WAF 4R7 T5E | ROYAL OHM | rezistor | 10 |  |  |  | Rezistor SMD, chip, 0805, 4.7Ω, ±1%, 0.125W | TME România | 0.0367 | 0.367
5 | 10 | (LINK) (http://www.tme.eu/ro/details/smd0805-10r-1%25/rezistente-smd-0805/royal-ohm/0805s8f100jt5e/) | SMD0805-10R-1% | 0805S8F100JT5E | ROYAL OHM | rezistor | 10 |  |  |  | Rezistor SMD, chip, 0805, 10Ω, ±1%, 0.125W | TME România | 0.03041 | 0.3041
6 | 22 | (LINK) (http://www.tme.eu/ro/details/smd0805-22r-1%25/rezistente-smd-0805/royal-ohm/0805s8f220jt5e/) | SMD0805-22R-1% | 0805S8F220JT5E | ROYAL OHM | rezistor | 20 |  |  |  | Rezistor SMD, chip, 0805, 22Ω, ±1%, 0.125W | TME România | 0.03041 | 0.6082
7 | 33 | (LINK) (http://www.tme.eu/ro/details/smd0805-33r-1%25/rezistente-smd-0805/royal-ohm/0805s8f330jt5e/) | SMD0805-33R-1% | 0805S8F330JT5E | ROYAL OHM | rezistor | 20 |  |  |  | Rezistor SMD, chip, 0805, 33Ω, ±1%, 0.125W | TME România | 0.03041 | 0.6082
8 | 51 | (LINK) (http://www.tme.eu/ro/details/rc0805jr-0751r/rezistente-smd-0805/yageo/rc0805jr-0751rl/) | SMD0805-51R-1% | 0805S8F510JT5E | ROYAL OHM | rezistor | 40 |  |  |  | Rezistor SMD, chip, 0805, 51Ω, ±1%, 0.125W | TME România | 0.03041 | 1.2164
9 | 68 | (LINK) (http://www.tme.eu/ro/details/smd0805-68r-1%25/rezistente-smd-0805/royal-ohm/0805s8f680jt5e/) | SMD0805-68R-1% | 0805S8F680JT5E | ROYAL OHM | rezistor | 10 |  |  |  | Rezistor SMD, chip, 0805, 68Ω, ±1%, 0.125W | TME România | 0.03041 | 0.3041
10 | 82 | (LINK) (https://www.tme.eu/ro/details/rc0805fr-0782r/rezistente-smd-0805/yageo/rc0805fr-0782rl/) | SMD0805-82R-1% | 0805S8F820JT5E | YAGEO | rezistor | 20 |  |  |  | Rezistor SMD, chip, 0805, 82Ω, ±1%, 0.125W | TME România | 0.03041 | 0.6082
11 | 100 | (LINK) (http://www.tme.eu/ro/details/smd0805-100r-1%25/rezistente-smd-0805/royal-ohm/0805s8f1000t5e/) | SMD0805-100R-1% | 0805S8F1000T5E | ROYAL OHM | rezistor | 60 |  | 3 |  | Rezistor SMD, chip, 0805, 100Ω, ±1%, 0.125W | TME România | 0.03041 | 1.8246
12 | 150 | (LINK) (https://www.tme.eu/ro/details/smd0805-150r/rezistente-smd-0805/royal-ohm/0805s8j0151t5e/) | SMD0805-150R-1% | 0805S8F1500T5E | ROYAL OHM | rezistor | 30 |  | 2 |  | Rezistor SMD, chip, 0805, 150Ω, ±1%, 0.125W | TME România | 0.03041 | 0.9123
13 | 220 | (LINK) (http://www.tme.eu/ro/details/smd0805-220r-1%25/rezistente-smd-0805/royal-ohm/0805s8f2200t5e/) | SMD0805-220R-1% | 0805S8F2200T5E | ROYAL OHM | rezistor | 30 |  |  |  | Rezistor SMD, chip, 0805, 220Ω, ±1%, 0.125W | TME România | 0.03041 | 0.9123
14 | 330 | (LINK) (http://www.tme.eu/ro/details/smd0805-330r-1%25/rezistente-smd-0805/royal-ohm/0805s8f3300t5e/) | SMD0805-330R-1% | 0805S8F3300T5E | ROYAL OHM | rezistor | 30 |  |  |  | Rezistor SMD, chip, 0805, 330Ω, ±1%, 0.125W | TME România | 0.03041 | 0.9123
15 | 470 | (LINK) (http://www.tme.eu/ro/details/smd0805-470r-1%25/rezistente-smd-0805/royal-ohm/0805s8f4700t5e/) | SMD0805-470R-1% | 0805S8F4700T5E | ROYAL OHM | rezistor | 30 |  |  |  | Rezistor SMD, chip, 0805, 470Ω, ±1%, 0.125W | TME România | 0.03041 | 0.9123
16 | 510 | (LINK) (https://www.tme.eu/ro/details/rc0805jr-07510r/rezistente-smd-0805/yageo/rc0805jr-07510rl/) | SMD0805-510R-5% | 0805S8J0511T5E | YAGEO | rezistor | 30 |  |  |  | Rezistor SMD, chip, 0805, 510Ω, ±5%, 0.125W | TME România | 0.03041 | 0.9123
17 | 680 | (LINK) (http://www.tme.eu/ro/details/smd0805-680r-1%25/rezistente-smd-0805/royal-ohm/0805s8f6800t5e/) | SMD0805-680R-1% | 0805S8F6800T5E | ROYAL OHM | rezistor | 30 |  |  |  | Rezistor SMD, chip, 0805, 680Ω, ±1%, 0.125W | TME România | 0.03041 | 0.9123
18 | 820 | (LINK) (http://www.tme.eu/ro/details/smd0805-820r-1%25/rezistente-smd-0805/royal-ohm/0805s8f8200t5e/) | SMD0805-820R-1% | 0805S8F8200T5E | ROYAL OHM | rezistor | 30 |  |  |  | Rezistor SMD, chip, 0805, 820Ω, ±1%, 0.125W | TME România | 0.03041 | 0.9123
19 | 910 | (LINK) (https://www.tme.eu/ro/details/smd0805-910r-1%25/rezistente-smd-0805/royal-ohm/0805s8f9100t5e/) | SMD0805-910R-5% | 0805WAJ 910R T5E | ROYAL OHM | rezistor | 40 |  |  |  | Rezistor SMD, chip, 0805, 910Ω, ±5%, 0.125W | TME România | 0.03041 | 1.2164
20 | 1k | (LINK) (http://www.tme.eu/ro/details/smd0805-1k-1%25/rezistente-smd-0805/royal-ohm/0805s8f1001t5e/) | SMD0805-1K-1% | 0805S8F1001T5E | ROYAL OHM | rezistor | 100 |  |  |  | Rezistor SMD, chip, 0805, 1kΩ, ±1%, 0.125W | TME România | 0.03041 | 3.041
21 | 1.5k | (LINK) (http://www.tme.eu/ro/details/smd0805-1k5-1%25/rezistente-smd-0805/royal-ohm/0805s8f1501t5e/) | SMD0805-1K5-1% | 0805S8F1501T5E | ROYAL OHM | rezistor | 40 |  |  |  | Rezistor SMD, chip, 0805, 1.5kΩ, ±1%, 0.125W | TME România | 0.03041 | 1.2164
22 | 1.8k | (LINK) (http://www.tme.eu/ro/details/smd0805-1k8-1%25/rezistente-smd-0805/royal-ohm/0805s8f1801t5e/) | SMD0805-1K8-1% | 0805S8F1801T5E | ROYAL OHM | rezistor | 30 |  |  |  | Rezistor SMD, chip, 0805, 1.8kΩ, ±1%, 0.125W | TME România | 0.03041 | 0.9123
23 | 2k | (LINK) (http://www.tme.eu/ro/details/smd0805-2k-1%25/rezistente-smd-0805/royal-ohm/0805s8f2001t5e/) | SMD0805-2K-1% | 0805S8F2001T5E | ROYAL OHM | rezistor | 80 |  | 1 |  | Rezistor SMD, chip, 0805, 2kΩ, ±1%, 0.125W | TME România | 0.03041 | 2.4328
24 | 2.2k | (LINK) (http://www.tme.eu/ro/details/smd0805-2k2-1%25/rezistente-smd-0805/royal-ohm/0805s8f2201t5e/) | SMD0805-2K2-1% | 0805S8F2201T5E | ROYAL OHM | rezistor | 30 |  | 1 |  | Rezistor SMD, chip, 0805, 2.2kΩ, ±1%, 0.125W | TME România | 0.03041 | 0.9123
25 | 2.7k | (LINK) (https://www.tme.eu/ro/details/smd0805-2k7/rezistente-smd-0805/royal-ohm/0805s8j0272t5e/) | SMD0805-2K7-1% | 0805S8F2701T5E | ROYAL OHM | rezistor | 30 |  |  |  | Rezistor SMD, chip, 0805, 2.7kΩ, ±1%, 0.125W | TME România | 0.03041 | 0.9123
26 | 3.3k | (LINK) (http://www.tme.eu/ro/details/smd0805-3k3-1%25/rezistente-smd-0805/royal-ohm/0805s8f3301t5e/) | SMD0805-3K3-1% | 0805S8F3301T5E | ROYAL OHM | rezistor | 30 |  |  |  | Rezistor SMD, chip, 0805, 3.3kΩ, ±1%, 0.125W | TME România | 0.03041 | 0.9123
27 | 3.9k | (LINK) (http://www.tme.eu/ro/details/smd0805-3k9-1%25/rezistente-smd-0805/royal-ohm/0805s8f3901t5e/) | SMD0805-3K9-1% | 0805S8F3901T5E | ROYAL OHM | rezistor | 20 |  |  |  | Rezistor SMD, chip, 0805, 3.9kΩ, ±1%, 0.125W | TME România | 0.03041 | 0.6082
28 | 4.7k | (LINK) (http://www.tme.eu/ro/details/smd0805-4k7-1%25/rezistente-smd-0805/royal-ohm/0805s8f4701t5e/) | SMD0805-4K7-1% | 0805S8F4701T5E | ROYAL OHM | rezistor | 30 |  | 1 |  | Rezistor SMD, chip, 0805, 4.7kΩ, ±1%, 0.125W | TME România | 0.03041 | 0.9123
29 | 5.6k | (LINK) (https://www.tme.eu/ro/details/rc0805jr-075k6/rezistente-smd-0805/yageo/rc0805jr-075k6l/) | SMD0805-5K6-1% | 0805S8F5601T5E | YAGEO | rezistor | 60 |  |  |  | Rezistor SMD, chip, 0805, 5.6kΩ, ±1%, 0.125W | TME România | 0.03041 | 1.8246
30 | 6.8k | (LINK) (http://www.tme.eu/ro/details/smd0805-6k8-1%25/rezistente-smd-0805/royal-ohm/0805s8f6801t5e/) | SMD0805-6K8-1% | 0805S8F6801T5E | ROYAL OHM | rezistor | 20 |  |  |  | Rezistor SMD, chip, 0805, 6.8kΩ, ±1%, 0.125W | TME România | 0.03041 | 0.6082
31 | 8.2k | (LINK) (http://www.tme.eu/ro/details/smd0805-8k2-1%25/rezistente-smd-0805/royal-ohm/0805s8f8201t5e/) | SMD0805-8K2-1% | 0805S8F8201T5E | ROYAL OHM | rezistor | 30 |  |  |  | Rezistor SMD, chip, 0805, 8.2kΩ, ±1%, 0.125W | TME România | 0.03041 | 0.9123
32 | 9.1k | (LINK) (http://www.tme.eu/ro/details/smd0805-9k1-1%25/rezistente-smd-0805/royal-ohm/0805waf-9k1-t5e/) | SMD0805-9K1-1% | CRCW080510K0FKTABC | VISHAY | rezistor | 20 |  |  |  | Rezistor SMD, chip, 0805, 9.1kΩ, ±1%, 0.125W | TME România | 0.03041 | 0.6082
33 | 10k | (LINK) (http://www.tme.eu/ro/details/crcw080510k0fktabc/rezistente-smd-0805/vishay/) | SMD0805-10K-1% | 0805S8F1002T5E | ROYAL OHM | rezistor | 100 |  | 3 |  | Rezistor SMD, chip, 0805, 10kΩ, ±1%, 0.125W | TME România | 0.03041 | 3.041
34 | 15k | (LINK) (http://www.tme.eu/ro/details/smd0805-15k-1%25/rezistente-smd-0805/royal-ohm/0805s8f1502t5e/) | SMD0805-15K-1% | 0805S8F1502T5E | ROYAL OHM | rezistor | 30 |  |  |  | Rezistor SMD, chip, 0805, 15kΩ, ±1%, 0.125W | TME România | 0.03041 | 0.9123
35 | 22k | (LINK) (http://www.tme.eu/ro/details/smd0805-22k-1%25/rezistente-smd-0805/royal-ohm/0805s8f2202t5e/) | SMD0805-22K-1% | 0805S8F2202T5E | ROYAL OHM | rezistor | 30 |  | 1 |  | Rezistor SMD, chip, 0805, 22kΩ, ±1%, 0.125W | TME România | 0.03041 | 0.9123
36 | 47k | (LINK) (http://www.tme.eu/ro/details/smd0805-47k/rezistente-smd-0805/royal-ohm/0805s8j0473t5e/) | 0805S8J0473T5E | 0805S8J0473T5E | ROYAL OHM | rezistor | 40 |  |  |  | Rezistor: thick film; SMD; 0805; 47kΩ; 0,125W; ±5%; -55÷125°C | TME România | 0.03041 | 1.2164
37 | 68k | (LINK) (http://www.tme.eu/ro/details/rc0805jr-0768k/rezistente-smd-0805/yageo/rc0805jr-0768kl/) | SMD0805-68K-5% | RC0805JR-0768KL | Yageo | rezistor | 20 |  |  |  | Rezistor SMD, chip, 0805, 68kΩ, ±5%, 0.125W | TME România | 0.03041 | 0.6082
38 | 100k | (LINK) (http://www.tme.eu/ro/details/smd0805-100k-1%25/rezistente-smd-0805/royal-ohm/0805s8f1003t5e/) | SMD0805-100K-1% | 0805S8F1003T5E | ROYAL OHM | rezistor | 100 |  |  |  | Rezistor SMD, chip, 0805, 100kΩ, ±1%, 0.125W | TME România | 0.03041 | 3.041
39 | 150k | (LINK) (http://www.tme.eu/ro/details/smd0805-150k/rezistente-smd-0805/royal-ohm/0805s8j0154t5e/) | SMD0805-150K-5% | 0805S8J0154T5E | ROYAL OHM | rezistor | 30 |  |  |  | Rezistor SMD, chip, 0805, 150kΩ, ±5%, 0.125W | TME România | 0.03041 | 0.9123
40 | 180k | (LINK) (http://www.tme.eu/ro/details/smd0805-180k/rezistente-smd-0805/royal-ohm/0805s8j0184t5e/) | SMD0805-180K-5% | 0805S8J0184T5E | ROYAL OHM | rezistor | 30 |  |  |  | Rezistor SMD, chip, 0805, 180kΩ, ±5%, 0.125W | TME România | 0.03041 | 0.9123
41 | 220k | (LINK) (http://www.tme.eu/ro/details/smd0805-220k-1%25/rezistente-smd-0805/royal-ohm/0805s8f2203t5e/) | SMD0805-220K-1% | 0805S8F2203T5E | ROYAL OHM | rezistor | 30 |  |  |  | Rezistor SMD, chip, 0805, 220kΩ, ±1%, 0.125W | TME România | 0.03041 | 0.9123
42 | 330k | (LINK) (http://www.tme.eu/ro/details/smd0805-330k-1%25/rezistente-smd-0805/royal-ohm/0805s8f3303t5e/) | SMD0805-330K-1% | 0805S8F3303T5E | ROYAL OHM | rezistor | 30 |  |  |  | Rezistor SMD, chip, 0805, 330kΩ, ±1%, 0.125W | TME România | 0.03041 | 0.9123
43 | 390k | (LINK) (http://www.tme.eu/ro/details/smd0805-390k-1%25/rezistente-smd-0805/royal-ohm/0805s8f3903t5e/) | SMD0805-390K-1% | 0805S8F3903T5E | ROYAL OHM | rezistor | 30 |  |  |  | Rezistor SMD, chip, 0805, 390kΩ, ±1%, 0.125W | TME România | 0.03041 | 0.9123
44 | 510k | (LINK) (http://www.tme.eu/ro/details/smd0805-510k-1%25/rezistente-smd-0805/royal-ohm/0805s8f5103t5e/) | SMD0805-510K-1% | 0805S8F5103T5E | ROYAL OHM | rezistor | 30 |  |  |  | Rezistor SMD, chip, 0805, 510kΩ, ±1%, 0.125W | TME România | 0.03041 | 0.9123
45 | 1M | (LINK) (http://www.tme.eu/ro/details/smd0805-1m/rezistente-smd-0805/royal-ohm/0805s8j0105t5e/) | SMD0805-1M | 0805S8J0105T5E | ROYAL OHM | rezistor | 30 |  |  |  | Rezistor SMD, chip, 0805, 1MΩ, ±1%, 0.125W | TME România | 0.02622 | 0.7866
46 | 2M | (LINK) (http://www.tme.eu/ro/details/smd0805-2m/rezistente-smd-0805/royal-ohm/0805waj-2m-t5e/) | SMD0805-2M7 | 0805WAJ 2M T5E | ROYAL OHM | rezistor | 30 |  |  |  | Rezistor SMD, chip, 0805, 2MΩ, ±1%, 0.125W | TME România | 0.02622 | 0.7866
47 | 5M | (LINK) (http://www.tme.eu/ro/details/smd0805-5m1/rezistente-smd-0805/royal-ohm/0805s8j0515t5e/) | SMD0805-5M1 | RC0805FR-075M1 | Yageo | rezistor | 30 |  |  |  | Rezistor SMD, chip, 0805, 5.1MΩ, ±1%, 0.125W | TME România | 0.03345 | 1.0035
48 | 10M | (LINK) (http://www.tme.eu/ro/details/rc0805jr-0710m/rezistente-smd-0805/yageo/rc0805jr-0710ml/) | SMD0805-10M | YAGEO RC0805JR-0710ML | YAGEO | rezistor | 40 |  |  |  | Rezistor SMD, chip, 0805, 10MΩ, ±5%, 0.125W | TME România | 0.02622 | 1.0488
49 | 100ohm | (LINK) (https://www.tme.eu/ro/details/ts53yl100r/trimere-smd-cu-o-singura-tura/vishay/ts53yl101mr10/) | 1804GSMD-100R | 1804GSMD-100R | SR PASSIVES | potențiometru | 15 |  | 1 |  | Potențiome-tru liniar, simplă tură, SMD, 100Ω, ±10%, 100ppm/°C, 0.25W | TME România | 2.4015 | 36.0225
50 | 500ohm | (LINK) (https://www.tme.eu/ro/details/ts53yl500r/trimere-smd-cu-o-singura-tura/vishay/ts53yl501mr10/) | 1804GSMD-500R | 1804GSMD-500R | VISHAY | potențiometru | 0 |  |  |  | Potențiome-tru liniar, simplă tură, SMD, 500Ω, ±10%, 100ppm/°C, 0.25W | TME România | 2.81 | 0
51 | 2k | (LINK) (https://www.tme.eu/ro/details/ts53yl2k/trimere-smd-cu-o-singura-tura/vishay/ts53yl202mr10/) | TS53YL202MR10 | TS53YL202MR10 | VISHAY | potențiometru | 0 |  |  |  | Potențiome-tru liniar, simplă tură, SMD, 2kΩ, ±10%, 100ppm/°C, 0.25W | TME România | 2.81 | 0
52 | 5k | (LINK) (http://www.tme.eu/ro/details/3314g-1-502e/trimere-smd-cu-o-singura-tura/bourns/) | 3314G-1-502E | 3314G-1-502E | BOURNS | potențiometru | 0 |  |  |  | Potenţiometru: de montare; singură tură, orizontal; 5kΩ; 250mW | TME România | 2.81 | 0
53 | 10k | (LINK) (http://www.tme.eu/ro/details/ts53yl10k/trimere-smd-cu-o-singura-tura/vishay/ts53yl103mr10/) | TS53YL103MR10 | TS53YL103MR10 | VISHAY | potențiometru | 30 |  | 1 |  | Potenţiometru: de montare; singură tură; 10kΩ; 250mW; SMD; ±20% | TME România | 2.4015 | 72.045
54 | 50k | (LINK) (http://www.tme.eu/ro/details/1804gsmd-50k/trimere-smd-cu-o-singura-tura/sr-passives/) | 1804GSMD-50K | 1804GSMD-50K | SR PASSIVES | potențiometru | 0 |  |  |  | Potențiome-tru liniar, simplă tură, SMD, 50kΩ, ±10%, 100ppm/°C, 0.25W | TME România | 2.81 | 0
55 | 100k | (LINK) (http://www.tme.eu/ro/details/1804gsmd-100k/trimere-smd-cu-o-singura-tura/sr-passives/) | 1804GSMD-100k | 1804GSMD-100k | SR PASSIVES | potențiometru | 32 |  |  |  | Potențiome-tru liniar, simplă tură, SMD, 100kΩ, ±10%, 100ppm/°C, 0.25W | TME România | 2.4015 | 76.848
56 | 500k | (LINK) (http://www.tme.eu/ro/details/3314g-1-504e/trimere-smd-cu-o-singura-tura/bourns/) | 3314G-1-504E | 3314G-1-504E | BOURNS | potențiometru | 10 |  |  |  | Potenţiometru: de montare; singură tură, orizontal; 500kΩ; 250mW | TME România | 2.4015 | 24.015
 | TOTAL - Componente pasive (rezistoare de valori fixe şi reglabile) |  |  |  |  |  |  |  |  |  |  |  | CU TVA= | 0
57 | 4.7pF | (LINK) (http://www.tme.eu/ro/details/cc0805crnpo94r7/condensatoare-mlcc-smd-0805/yageo/cc0805crnpo9bn4r7/) | CC0805CRNPO9BN4R7 | CC0805CRNPO9BN4R7 | YAGEO | condensator | 15 |  |  |  | ceramic; MLCC; 4,7pF; 50V; C0G; ±0,25pF; SMD; 0805 | TME România | 0.0409 | 0.6135
58 | 10pF | (LINK) (http://www.tme.eu/ro/details/cc0805jrnpo9100/condensatoare-mlcc-smd-0805/yageo/cc0805jrnpo9bn100/) | CC0805JRNPO9BN100 | CC0805JRNPO9BN100 | YAGEO | condensator | 15 |  |  |  | ceramic; MLCC; 10pF; 50V; C0G; ±5%; SMD; 0805 | TME România | 0.0409 | 0.6135
59 | 47pF | (LINK) (http://www.tme.eu/ro/details/cl21c470jbannnc/condensatoare-mlcc-smd-0805/samsung/) | CL21C470JBANNNC | CL21C470JBANNNC | SAMSUNG | condensator | 15 |  |  |  | Condensator: ceramic; MLCC; 47pF; 50V; C0G; ±5%; SMD; 0805; -55÷125°C | TME România | 0.03046 | 0.4569
60 | 100pF | (LINK) (http://www.tme.eu/ro/details/cl21c101jbannnc/condensatoare-mlcc-smd-0805/samsung/) | CL21C101JBANNNC | CL21C101JBANNNC | SAMSUNG | condensator | 20 |  |  |  | Condensator: ceramic; MLCC; 100pF; 50V; C0G; ±5%; SMD; 0805 | TME România | 0.0367 | 0.734
61 | 470pF | (LINK) (http://www.tme.eu/ro/details/08051c471kat2a/condensatoare-mlcc-smd-0805/avx/) | 08051C471KAT2A | 08051C471KAT2A | AVX | condensator | 20 |  |  |  | Condensator: ceramic; 470pF; 100V; X7R; ±10%; SMD; 0805 | TME România | 0.02087 | 0.4174
62 | 1nF | (LINK) (http://www.tme.eu/ro/details/c0805c102j5gac/condensatoare-mlcc-smd-0805/kemet/) | C0805C102J5GAC | C0805C102J5GAC | KEMET | condensator | 40 |  |  |  | Condensator MLCC, SMD, 0805, 1nF, ±5%, 50V, C0G | TME România | 0.06187 | 2.4748
63 | 2.2nF | (LINK) (http://www.tme.eu/ro/details/cl21b222kbannnd/condensatoare-mlcc-smd-0805/samsung/) | CL21B222KBANNND | CL21B222KBANNND | SAMSUNG | condensator | 40 |  | 1 |  | Condensator: ceramic; MLCC; 2,2nF; 50V; X7R; ±10%; SMD; 0805 | TME România | 0.02821 | 1.1284
64 | 4.7nF | (LINK) (http://www.tme.eu/ro/details/c0805c472k5rac/condensatoare-mlcc-smd-0805/kemet/) | C0805C472K5RAC | C0805C472K5RAC | KEMET | condensator | 40 |  |  |  | Condensator MLCC, SMD, 0805, 4.7nF, ±5%, 50V, X7R | TME România | 0.04509 | 1.8036
65 | 5.6nF | (LINK) (http://www.tme.eu/ro/details/cl21b562kbannnc/condensatoare-mlcc-smd-0805/samsung/) | CL21B562KBANNNC | CL21B562KBANNNC | SAMSUNG | condensator | 40 |  |  |  | Condensator MLCC, SMD, 0805, 5.6nF, ±5%, 50V, X7R | TME România | 0.02622 | 1.0488
66 | 10nF | (LINK) (http://www.tme.eu/ro/details/cl21b103kcannnc/condensatoare-mlcc-smd-0805/samsung/) | CL21B103KCANNNC | CL21B103KCANNNC | SAMSUNG | condensator | 40 |  | 1 |  | Condensator MLCC, SMD, 0805, 10nF, ±5%, 50V, X7R | TME România | 0.02821 | 1.1284
67 | 22nF | (LINK) (http://www.tme.eu/ro/details/cl21b223kcfnnne/condensatoare-mlcc-smd-0805/samsung/) | CL21B223KCFNNNE | CL21B223KCFNNNE | SAMSUNG | condensator | 40 |  |  |  | Condensator: ceramic; MLCC; 22nF; 100V; X7R; ±10%; SMD; 0805 | TME România | 0.0366 | 1.464
68 | 33nF | (LINK) (http://www.tme.eu/ro/details/cl21b333kbannnc/condensatoare-mlcc-smd-0805/samsung/) | CL21B333KBANNNC | CL21B333KBANNNC | SAMSUNG | condensator | 40 |  | 1 |  | Condensator: ceramic; MLCC; 33nF; 50V; X7R; ±10%; SMD; 0805 | TME România | 0.0409 | 1.636
69 | 100nF | (LINK) (http://www.tme.eu/ro/details/cc0805krx7r9104/condensatoare-mlcc-smd-0805/yageo/cc0805krx7r9bb104/) | CC0805KRX7R9BB104 | CC0805KRX7R9BB104 | YAGEO | condensator | 40 |  |  |  | ceramic; MLCC; 100nF; 50V; X7R; ±10%; SMD; 0805 | TME România | 0.02622 | 1.0488
70 | 220nF | (LINK) (http://www.tme.eu/ro/details/cl21b224kafnnne/condensatoare-mlcc-smd-0805/samsung/) | CL21B224KAFNNNE | CL21B224KAFNNNE | SAMSUNG | condensator | 40 |  |  |  | Condensator: ceramic; MLCC; 220nF; 25V; X7R; ±10%; SMD; 0805 | TME România | 0.0409 | 1.636
71 | 330nF | (LINK) (http://www.tme.eu/ro/details/08055c334kat2a/condensatoare-mlcc-smd-0805/avx/) | 08055C334KAT2A | 08055C334KAT2A | AVX | condensator | 30 |  |  |  | Condensator: ceramic; MLCC; 330nF; 50V; X7R; ±10%; SMD; 0805 | TME România | 0.2506 | 7.518
72 | 470nF | (LINK) (http://www.tme.eu/ro/details/grm21br72a474ka73l/condensatoare-mlcc-smd-0805/murata/) | CC0805MRY5V8BB474 | CC0805MRY5V8BB474A | MURATA | condensator | 30 |  |  |  | Condensator: ceramic; MLCC; 470nF; 100V; X7R; ±10%; SMD; 0805 | TME România | 0.05065 | 1.5195
73 | 1uF | (LINK) (http://www.tme.eu/ro/details/cl21b105kbfnnne/condensatoare-mlcc-smd-0805/samsung/) | CL21B105KBFNNNE | CL21B105KBFNNNE | SAMSUNG | condensator | 20 |  |  |  | Condensator: ceramic; MLCC; 1uF; 50V; X7R; ±10%; SMD; 0805 | TME România | 0.06911 | 1.3822
74 | 2.2uF | (LINK) (http://www.tme.eu/ro/details/grm219r61e225ka12d/condensatoare-mlcc-smd-0805/murata/) | GRM219R61E225KA12D | GRM219R61E225KA12D | MURATA | condensator | 20 |  |  |  | Condensator: ceramic; MLCC; 2,2uF; 25V; X5R; ±10%; SMD; 0805 | TME România | 0.08096 | 1.6192
75 | 4.7uF | (LINK) (http://www.tme.eu/ro/details/cl21a475kaqnnne/condensatoare-mlcc-smd-0805/samsung/) | GRM21BR72A474KA73L | GRM21BR72A474KA73L | MURATA | condensator | 20 |  |  |  | ceramic; MLCC; 4,7uF; 25V; X5R; ±10%; SMD; 0805 | TME România | 0.09963 | 1.9926
76 | 10uF | (LINK) (http://www.tme.eu/ro/details/eeefk1j100p/condensatoare-electrol-smd-imped-joasa/panasonic/) | EEEFK1J100P | EEEFK1J100P | PANASONIC | condensator | 16 |  |  |  | Condensator: electrolitic; cu impedanţă redusă; SMD; 10uF; 63V | TME România | 0.79 | 12.64
 | TOTAL - Componente pasive (condensatoare) |  |  |  |  |  |  |  |  |  |  |  | CU TVA= | 0
77 | 4148 | (LINK) (http://www.tme.eu/ro/details/1n4148-0805/diode-universale-smd/dc-components/cd4148ws0805c/) | 1N4148-0805 | CD4148WS(0805C) | DC Components | diodă pn | 60 |  |  |  | Diodă comutație, SMD, 0805, 300mA, 100V | TME România | 0.045 | 2.7
78 | LED | (LINK) (http://www.tme.eu/ro/details/kp-2012src-prv/led-uri-smd-0805/kingbright-electronic/) | KP-2012SRC-PRV | KP-2012SRC-PRV | Kingbright Electronic | LED | 15 |  | 1 |  | LED roșu, SMD, 0805, 100mcd, 640nm, 120° | TME România | 0.33109 | 4.96635
79 | 2.7V | (LINK) (https://www.tme.eu/ro/details/bzx84-c2v7.215/diode-zener-smd/nexperia/bzx84-c2v7-215/) | BZX84C2V7 | BZX84-C2V7LT1G | NEXPERIA | diodă Zener | 0 |  |  |  | Diodă Zener, SMD, SOT23, 2,7V, ±5%, 0.25W | TME România | 0.061 | 0
80 | 5.1V | (LINK) (https://www.tme.eu/ro/details/bzx84-c5v1.215/diode-zener-smd/nexperia/) | BZX84C5V1 | BZX84-C5V1 | NEXPERIA | diodă Zener | 30 |  | 1 |  | Diodă Zener, SMD, SOT23, 5,1V, ±5%, 0.3W | TME România | 0.0562 | 1.686
81 | 5.6V | (LINK) (https://www.tme.eu/ro/details/bzx84c5v6lt1g/diode-zener-smd/onsemi/) | BZX84C5V6 | BZX84-C5V6 | ON Semiconductor | diodă Zener | 30 |  |  |  | Diodă Zener, SMD, SOT23, 5,6V, ±5%, 0.3W | TME România | 0.0526 | 1.578
82 | 6.2V | (LINK) (https://www.tme.eu/ro/details/bzx84-c6v2.215/diode-zener-smd/nexperia/) | BZX84C6V2 | BZX84-C6V2 | NEXPERIA | diodă Zener | 0 |  |  |  | Diodă Zener, SMD, SOT23, 6.2V, ±5%, 0.3W | TME România | 0.0535 | 0
83 | 6.8V | (LINK) (https://www.tme.eu/ro/details/bzx84-c6v8.215/diode-zener-smd/nexperia/) | BZX84C6V8 | BZX84-C6V8 | NEXPERIA | diodă Zener | 0 |  |  |  | Diodă Zener, SMD, SOT23, 6.8V, ±5%, 0.3W | TME România | 0.0526 | 0
84 | 8.2V | (LINK) (https://www.tme.eu/ro/details/bzx84-c8v2.215/diode-zener-smd/nexperia/) | BZX84C8V2 | BZX84-C8V2 | NEXPERIA | diodă Zener | 0 |  |  |  | Diodă Zener, SMD, SOT23, 8.2V, ±5%, 0.3W | TME România | 0.0517 | 0
85 | 10V | (LINK) (https://www.tme.eu/ro/details/bzx84-c10.215/diode-zener-smd/nexperia/) | BZX84C10 | BZX84-C10 | NEXPERIA | diodă Zener | 0 |  |  |  | Diodă Zener, SMD, SOT23, 10V, ±5%, 0.3W | TME România | 0.057 | 0
86 | PNP | (LINK) (http://www.tme.eu/ro/details/bc856b-dio/tranzistori-smd-pnp/diotec-semiconductor/bc856b/) | BC856B | BC856B | DIOTEC | tranzistor bipolar | 100 |  | 4 |  | Tranzistor bipolar PNP, SMD, SOT23, 80V, 100mA | TME România | 0.0401 | 4.01
87 | NPN | (LINK) (http://www.tme.eu/ro/details/bc846b.215/tranzistori-smd-npn/nxp/) | BC846B | BC846B | NXP | tranzistor bipolar | 100 |  | 6 |  | Tranzistor bipolar NPN, SMD, SOT23, 65V, 100mA | TME România | 0.0481 | 4.81
89 | N-JFET | (LINK) (http://www.tme.eu/ro/details/mmbfj309lt1g/tranzistori-canal-n-smd/on-semiconductor/) | MMBFJ309LT1G | MMBFJ309LT1G | ON Semiconductor | tranzistor NJFET | 30 |  |  |  | Tranzistor N-JFET, SMD, SOT23, 25V, 30mA | TME România | 0.3503 | 10.509
90 | P-JFET | (LINK) (http://www.tme.eu/ro/details/mmbfj177lt1g/tranzistori-canal-p-smd/on-semiconductor/) | MMBFJ177LT1G | MMBFJ177LT1G | ON Semiconductor | tranzistor PJFET | 0 |  |  |  | Tranzistor P-JFET, SMD, SOT23, 30V, 20mA | TME România | 0.8236 | 0
91 | NPN | (LINK) (http://www.tme.eu/ro/details/bc817-25-dio/tranzistori-smd-npn/diotec-semiconductor/bc817-25/) | BC817-25-DIO | BC817-25-DIO | NXP | tranzistor bipolar | 15 |  |  |  | Tranzistor bipolar NPN, SMD, SOT23, 45V, 800mA | TME România | 0.047 | 0.705
93 | PNP | (LINK) (http://www.tme.eu/ro/details/bc807-25-dio/tranzistori-smd-pnp/diotec-semiconductor/bc807-25/) | BC807-25-DIO | BC807-25-DIO | NXP | tranzistor bipolar | 15 |  |  |  | Tranzistor bipolar PNP, SMD, SOT23, 45V, 800mA | TME România | 0.0527 | 0.7905
94 | NPN | (LINK) (http://www.tme.eu/ro/details/mjd31cg/tranzistori-smd-npn/on-semiconductor/) | MJD31CG | MJD31CG | ON Semiconductor | tranzistor bipolar | 0 |  |  |  | Tranzistor bipolar NPN, SMD, DPACK, 100V, 3A, 15W | TME România | 0.5884 | 0
96 | PNP | (LINK) (http://www.tme.eu/ro/details/mjd32cg/tranzistori-smd-pnp/on-semiconductor/) | MJD32CG | MJD32CG | ON Semiconductor | tranzistor bipolar | 0 |  |  |  | Tranzistor bipolar PNP, SMD, DPACK, 100V, 3A, 15W | TME România | 0.6034 | 0
97 | Nmos | (LINK) (http://www.tme.eu/ro/details/irfr120npbf/tranzistori-canal-n-smd/international-rectifier/) | IRFR120NPBF | IRFR120NPBF | International Rectifier | tranzistor NMOS | 0 |  |  |  | Tranzistor N-MOSFET, SMD, DPAK, 100V, 9.1A, 20V, 39W | TME România | 0.8914 | 0
 | TOTAL - Componente semiconductoare (tranzistoare bipolare şi cu efect de câmp, diode, LED, etc.) |  |  |  |  |  |  |  |  |  |  |  | CU TVA= | 0
98 | Conn2p | (LINK) (http://www.tme.eu/ro/details/zl301-40p/pini-cu-benzi-si-soclu/ninigi/) | ZL301-40P | ZL301-40P | NINIGI | Sir pini, pas 2,54mm, SMD | 6 |  |  |  | Sir pini, pas 2,54mm, SMD, tip tata, bareta de 40 pini | TME România | 2.1918 | 13.1508
99 | FUSE | (LINK) (http://www.tme.eu/ro/details/3413.0116.11/sigurante-smd-1206-ultrarapide/schurter/) | 3413.0116.11 | 3413.0116.11 | SCHURTER | sigu-ranță | 0 |  |  |  | Siguranță sticlă, SMD, 1206, 1.25A, 48mΩ | TME România | 1.662 | 0
 | Total - Conectică, sigurante fuzibile, etc. |  |  |  |  |  |  |  |  |  | FARA TVA = | 13.1508 | CU TVA= | 16.306992
 | Total general |  |  |  |  |  |  |  |  |  | FARA TVA = | 13.1508 | CU TVA= | 16.306992

Sheet: Sheet2
Nr. Crt. | Nume | Catalog | Cod distrib | Nume prod | Prod | Clasă | Qty fix | Alveole | Qty min | Referință | Descriere | Distribuitor | Pret (fara TVA) referinta/buc. TME România | Pret total pe reper (fara TVA)
1 | 100 | (LINK) (http://www.tme.eu/ro/details/smd0805-100r-1%25/rezistente-smd-0805/royal-ohm/0805s8f1000t5e/) | SMD0805-100R-1% | 0805S8F1000T5E | ROYAL OHM | rezistor | 60 | 5b | 3 | R6,R11,R12 | Rezistor SMD, chip, 0805, 100Ω, ±1%, 0.125W | TME România | 0.03041 | 1.8246
2 | 150 | (LINK) (https://www.tme.eu/ro/details/smd0805-150r/rezistente-smd-0805/royal-ohm/0805s8j0151t5e/) | SMD0805-150R-1% | 0805S8F1500T5E | ROYAL OHM | rezistor | 30 | 6a | 2 | R1,R2 | Rezistor SMD, chip, 0805, 150Ω, ±1%, 0.125W | TME România | 0.03041 | 0.9123
3 | 2k | (LINK) (http://www.tme.eu/ro/details/smd0805-2k-1%25/rezistente-smd-0805/royal-ohm/0805s8f2001t5e/) | SMD0805-2K-1% | 0805S8F2001T5E | ROYAL OHM | rezistor | 80 | 11b | 1 | R10 | Rezistor SMD, chip, 0805, 2kΩ, ±1%, 0.125W | TME România | 0.03041 | 2.4328
4 | 2.2k | (LINK) (http://www.tme.eu/ro/details/smd0805-2k2-1%25/rezistente-smd-0805/royal-ohm/0805s8f2201t5e/) | SMD0805-2K2-1% | 0805S8F2201T5E | ROYAL OHM | rezistor | 30 | 12a | 1 | R5 | Rezistor SMD, chip, 0805, 2.2kΩ, ±1%, 0.125W | TME România | 0.03041 | 0.9123
5 | 4.7k | (LINK) (http://www.tme.eu/ro/details/smd0805-4k7-1%25/rezistente-smd-0805/royal-ohm/0805s8f4701t5e/) | SMD0805-4K7-1% | 0805S8F4701T5E | ROYAL OHM | rezistor | 30 | 14a | 1 | R8 | Rezistor SMD, chip, 0805, 4.7kΩ, ±1%, 0.125W | TME România | 0.03041 | 0.9123
6 | 10k | (LINK) (http://www.tme.eu/ro/details/crcw080510k0fktabc/rezistente-smd-0805/vishay/) | SMD0805-10K-1% | 0805S8F1002T5E | ROYAL OHM | rezistor | 100 | 16b | 3 | R3,R4,R7 | Rezistor SMD, chip, 0805, 10kΩ, ±1%, 0.125W | TME România | 0.03041 | 3.041
7 | 22k | (LINK) (http://www.tme.eu/ro/details/smd0805-22k-1%25/rezistente-smd-0805/royal-ohm/0805s8f2202t5e/) | SMD0805-22K-1% | 0805S8F2202T5E | ROYAL OHM | rezistor | 30 | 17b | 1 | R9 | Rezistor SMD, chip, 0805, 22kΩ, ±1%, 0.125W | TME România | 0.03041 | 0.9123
8 | 100ohm | (LINK) (https://www.tme.eu/ro/details/ts53yl100r/trimere-smd-cu-o-singura-tura/vishay/ts53yl101mr10/) | 1804GSMD-100R | 1804GSMD-100R | SR PASSIVES | potențiometru | 15 | 24b | 1 | P1 | Potențiometru liniar, simplă tură, SMD, 100Ω, ±10%, 100ppm/°C, 0.25W | TME România | 2.4015 | 36.0225
9 | 10k | (LINK) (http://www.tme.eu/ro/details/ts53yl10k/trimere-smd-cu-o-singura-tura/vishay/ts53yl103mr10/) | TS53YL103MR10 | TS53YL103MR10 | VISHAY | potențiometru | 30 | 26b | 1 | P2 | Potenţiometru: de montare; singură tură; 10kΩ; 250mW; SMD; ±20% | TME România | 2.4015 | 72.045
10 | 2.2nF | (LINK) (http://www.tme.eu/ro/details/cl21b222kbannnd/condensatoare-mlcc-smd-0805/samsung/) | CL21B222KBANNND | CL21B222KBANNND | SAMSUNG | condensator | 40 | 31b | 1 | C3 | Condensator: ceramic; MLCC; 2,2nF; 50V; X7R; ±10%; SMD; 0805 | TME România | 0.02821 | 1.1284
11 | 10nF | (LINK) (http://www.tme.eu/ro/details/cl21b103kcannnc/condensatoare-mlcc-smd-0805/samsung/) | CL21B103KCANNNC | CL21B103KCANNNC | SAMSUNG | condensator | 40 | 33a | 1 | C2 | Condensator MLCC, SMD, 0805, 10nF, ±5%, 50V, X7R | TME România | 0.02821 | 1.1284
12 | 33nF | (LINK) (http://www.tme.eu/ro/details/cl21b333kbannnc/condensatoare-mlcc-smd-0805/samsung/) | CL21B333KBANNNC | CL21B333KBANNNC | SAMSUNG | condensator | 40 | 34a | 1 | C1 | Condensator: ceramic; MLCC; 33nF; 50V; X7R; ±10%; SMD; 0805 | TME România | 0.0409 | 1.636
13 | LED | (LINK) (http://www.tme.eu/ro/details/kp-2012src-prv/led-uri-smd-0805/kingbright-electronic/) | KP-2012SRC-PRV | KP-2012SRC-PRV | Kingbright Electronic | LED | 15 | 38a | 1 | D1 | LED roșu, SMD, 0805, 100mcd, 640nm, 120° | TME România | 0.33109 | 4.96635
14 | 5.1V | (LINK) (https://www.tme.eu/ro/details/bzx84-c5v1.215/diode-zener-smd/nexperia/) | BZX84C5V1 | BZX84-C5V1 | NEXPERIA | diodă Zener | 30 | 39a | 1 | D2 | Diodă Zener, SMD, SOT23, 5,1V, ±5%, 0.3W | TME România | 0.0562 | 1.686
15 | PNP | (LINK) (http://www.tme.eu/ro/details/bc856b-dio/tranzistori-smd-pnp/diotec-semiconductor/bc856b/) | BC856B | BC856B | DIOTEC | tranzistor bipolar | 100 | 41b | 4 | Q1,Q2,Q7,Q10 | Tranzistor bipolar PNP, SMD, SOT23, 80V, 100mA | TME România | 0.0401 | 4.01
16 | NPN | (LINK) (http://www.tme.eu/ro/details/bc846b.215/tranzistori-smd-npn/nxp/) | BC846B | BC846B | NXP | tranzistor bipolar | 100 | 42a | 6 | Q3,Q4,Q5,Q6,Q8,Q9 | Tranzistor bipolar NPN, SMD, SOT23, 65V, 100mA | TME România | 0.0481 | 4.81
