anananu/Square-wave-Generator/(list of files, drawings)

Other design files:
Schematics/GSD.DSN
Schematics/P1_CONECTORI.DSN
